vytrannguyenthao/STM32_Hardware_in_the_Loop/Report/Doc/TLTK.tex

\sloppy

\begin{thebibliography}{10}

\bibitem{hil_ni}
National Instruments, "What is Hardware-in-the-Loop (HIL)?",
\url{https://www.ni.com/en/solutions/transportation/hardware-in-the-loop/what-is-hardware-in-the-loop-.html}
(accessed: 12/5/2025).

\bibitem{can}
HQ Kvaser AB, "The CAN Bus Protocol Tutorial",
\url{https://kvaser.com/can-protocol-tutorial/}
(accessed: 12/5/2025).

\bibitem{rtos}
Jonathan Valvano, “Embedded Systems: Real-Time Operating Systems for ARM Cortex-M Microcontrollers”, 2017.

\bibitem{hil_ni}
Keysight Technologies, "What Is the Fourier Transform??", 
\url{https://www.keysight.com/used/us/en/knowledge/formulas/fourier-transform}
(accessed: 12/5/2025).

\bibitem{signal_process}
Sophocles J. Orfanidis, "Introduction to Signal and Processing", Rutgers University, 2010.

\bibitem{dsp}
Steven W. Smith, "The Scientist and Engineer's Guide to Digital Signal Processing", California Technical Publishing San Diego, 1999.

\bibitem{rm_f4}
STMicroelectronics, \textit{STM32F4x Series Reference Manual}, RM0090, 2023.

\bibitem{w25q}
Winbond Electronics Corporation, 
\textit{W25Q Series Serial Flash Memory Datasheet}, 2023.

\bibitem{ds1307}
Maxim Integrated, 
\textit{DS1307 I2C Real-Time Clock Datasheet}, 2016.

\bibitem{at24cxx}
Microchip Technology Inc., 
\textit{AT24Cxx I2C Serial EEPROM Datasheet}, 2018.

\bibitem{rasp_pi}
Raspberry Pi Ltd, 
\textit{RP2040 Datasheet A microcontroller by Raspberry Pi}, 2019.

\end{thebibliography}
