vytrannguyenthao/STM32_Hardware_in_the_Loop/Report/Doc/main.tex

\documentclass[12pt, a4paper]{extreport}
\usepackage[utf8]{vietnam}
\usepackage{mathptmx} % Gói lệnh để sử dụng font Times New Roman
\usepackage{amsmath,amsfonts,amssymb}
\usepackage{graphicx, float}
\usepackage[left=4cm, right=2.5cm, top=4cm, bottom=2.5cm]{geometry}
\usepackage{setspace}
\usepackage{array, booktabs, subcaption}
\usepackage{titlesec}
\usepackage{fancyhdr}
\usepackage{tikz}
\usetikzlibrary{calc,positioning,shapes,arrows}
\usepackage[titles]{tocloft} 
\usepackage{indentfirst}
\usepackage{pdfpages}
\usepackage{listings}
\usepackage{enumitem}
\usepackage{url}
\usepackage{tabularx}
\usepackage{pifont}
\usepackage{longtable}
\usepackage[hidelinks]{hyperref} % Hyperlink nên đặt ở cuối cùng
\usepackage{rotating}

\setlength{\emergencystretch}{3em}
\setcounter{secnumdepth}{3}

% --- Font size & line spacing ---
\renewcommand{\normalsize}{\fontsize{13}{15.6}\selectfont}
\normalsize % Lệnh bắt buộc để kích hoạt size 13pt
\setstretch{1.3} % Giãn dòng 1.3
\setlength{\parskip}{6pt}
\setlist[itemize]{itemsep=1pt, topsep=1pt, parsep=1pt}
\setlist[enumerate]{itemsep=1pt, topsep=1pt, parsep=1pt}

% --- Header & Footer ---
\pagestyle{fancy}
\fancyhf{}
\fancyhead[L]{\textit{Đồ án tốt nghiệp}}
\fancyhead[R]{\textit{GVHD: ThS. Bùi Quốc Bảo}}
\fancyfoot[C]{\thepage}

\fancypagestyle{plain}{
    \fancyhf{}
    \fancyhead[L]{\textit{Đồ án tốt nghiệp}}
    \fancyhead[R]{\textit{GVHD: ThS. Bùi Quốc Bảo}}
    \fancyfoot[C]{\thepage}
}

% \setlength{\headheight}{25pt}
% \setlength{\footskip}{20pt}
\setlength{\parindent}{20pt}

% --- Cấu hình lại khoảng cách cho hình ảnh/bảng ---
\setlength{\intextsep}{0pt} 
\setlength{\belowcaptionskip}{0pt}

% --- Đánh số liên tục Hình ảnh và Bảng biểu ---
\counterwithout{figure}{chapter}
\counterwithout{table}{chapter}

% --- TOC / LOF / LOT spacing ---
\setlength{\cftbeforetoctitleskip}{0pt}  % khoảng cách trước tiêu đề TOC
\setlength{\cftaftertoctitleskip}{10pt}  % khoảng cách sau tiêu đề TOC

\setlength{\cftbeforeloftitleskip}{0pt}  % trước LOF
\setlength{\cftafterloftitleskip}{10pt}  % sau LOF

\setlength{\cftbeforelottitleskip}{0pt}  % trước LOT
\setlength{\cftafterlottitleskip}{10pt}  % sau LOT

% --- Chapter style ---
\titleformat{\chapter}[block]
  {\fontsize{14}{16.8}\selectfont\bfseries\centering} % Cỡ chữ 14, in đậm, canh giữa
  {CHƯƠNG \thechapter}
  {1em} % Khoảng cách giữa số chương và tên chương
  {\MakeUppercase} % Tự động in hoa toàn bộ tên chương

\titlespacing*{\chapter}{0pt}{-30pt}{0pt}

% --- Chapter style (Dành cho LỜI CẢM ƠN, MỤC LỤC, TÓM TẮT...) ---
\titleformat{name=\chapter,numberless}[block]
  {\fontsize{14}{16.8}\selectfont\bfseries\centering}
  {}{0pt}
  {\MakeUppercase}
\titlespacing*{name=\chapter,numberless}{0pt}{-30pt}{0pt}

% --- Section style ---
\titleformat{\section}
  {\fontsize{13}{15.6}\selectfont\bfseries} % Size 13pt, in đậm
  {\thesection}
  {1em}
  {}
\titlespacing*{\section}{0pt}{0pt}{0pt} % Khoảng cách: trái, trên, dưới

% --- Subsection style ---
\titleformat{\subsection}
  {\fontsize{13}{15.6}\selectfont\bfseries\itshape} % Size 13pt, in đậm, in nghiêng
  {\thesubsection}
  {1em}
  {}
\titlespacing*{\subsection}{0pt}{0pt}{0pt}

% --- Subsubsection style---
\titleformat{\subsubsection}
  {\fontsize{13}{15.6}\selectfont\itshape} % Size 13pt, in nghiêng (không đậm)
  {\thesubsubsection}
  {1em}
  {}
\titlespacing*{\subsubsection}{0pt}{0pt}{0pt}

\begin{document}

% --- Trang bìa & lời cảm ơn ---
\pagenumbering{gobble} 
\input{titlepage}

\newpage
\newgeometry{left=3cm, right=2cm, top=1cm, bottom=1cm}
\input{nhiemvu}
\restoregeometry

\cleardoublepage
\pagenumbering{roman}
\input{loicamon}

\cleardoublepage
\input{tomtat}

% --- TOC / LOF / LOT ---
\cleardoublepage
\tableofcontents

\cleardoublepage
\begingroup
\renewcommand*{\addvspace}[1]{} % Vô hiệu hóa lệnh chèn khoảng trắng của LaTeX
\listoffigures
\endgroup

\cleardoublepage
\begingroup
\renewcommand*{\addvspace}[1]{} % Vô hiệu hóa lệnh chèn khoảng trắng của LaTeX
\listoftables
\endgroup

% --- Nội dung chương ---
\cleardoublepage
\pagenumbering{arabic}
\input{chuong1}

\newpage
\input{chuong2}

\newpage
\input{chuong3}

\newpage
\input{chuong4}

\newpage
\input{chuong5}

% \newpage
% \input{chuong6}

\newpage
\input{chuong7}

\newpage
\input{chuong8}

\newpage
\input{chuong9}

\newpage
\input{ketluan_huongphattrien}

\newpage
\input{TLTK}

\end{document}
