vytrannguyenthao/STM32_Hardware_in_the_Loop/HIL_project_HW/HIL_project.png

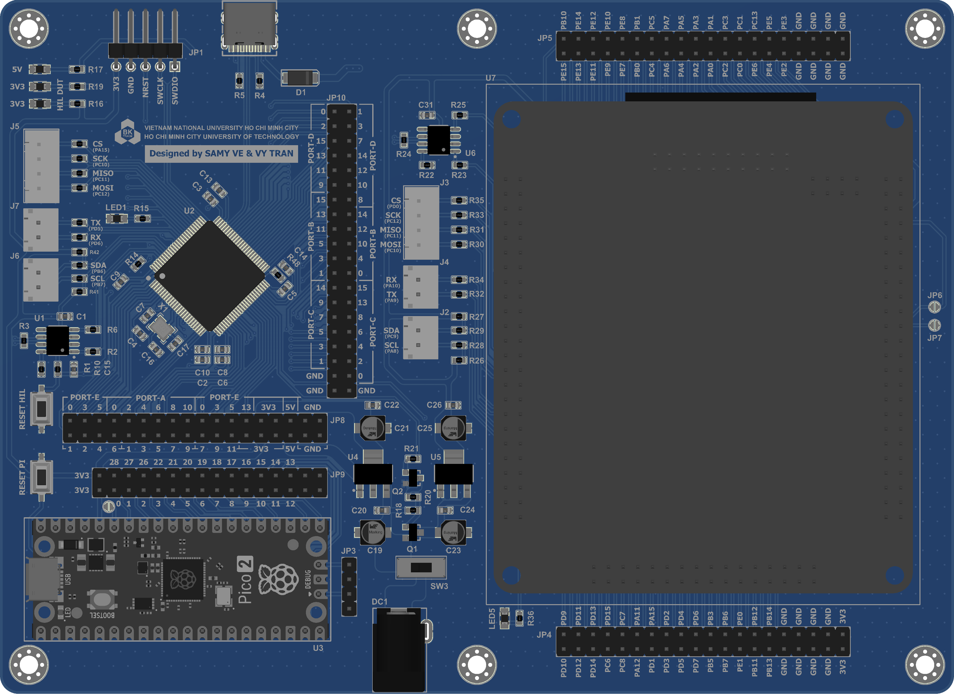
HIL_project_HW/HIL_project.png
