vytrannguyenthao/STM32_Hardware_in_the_Loop/Report/Doc/image/app_mem_emu.jpg

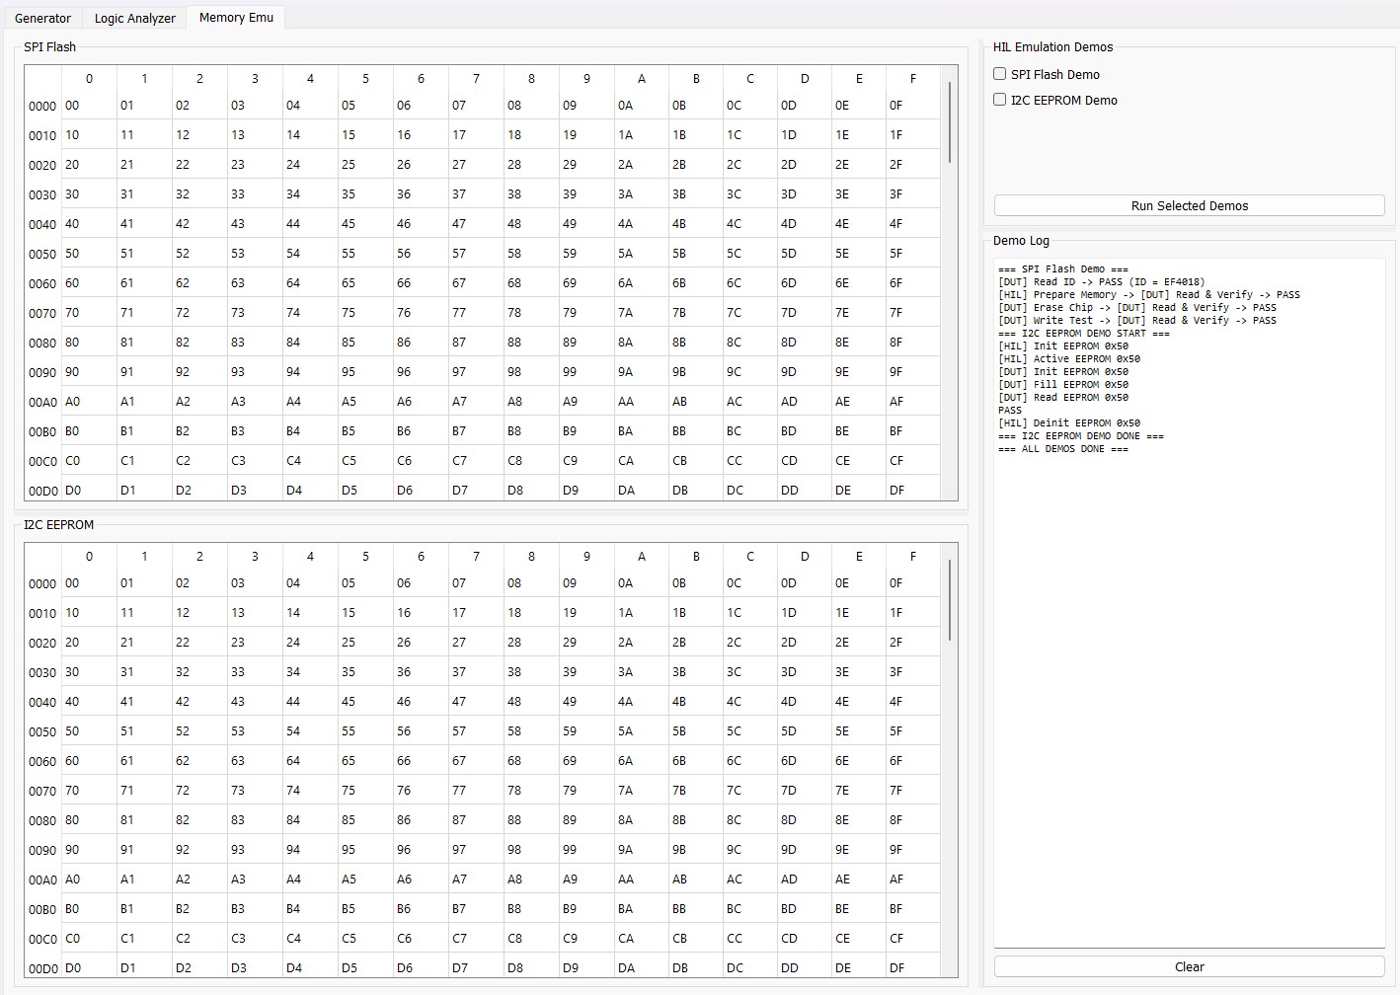
Report/Doc/image/app_mem_emu.jpg
