vytrannguyenthao/STM32_Hardware_in_the_Loop/Report/Doc/image/App_per_adc.jpg

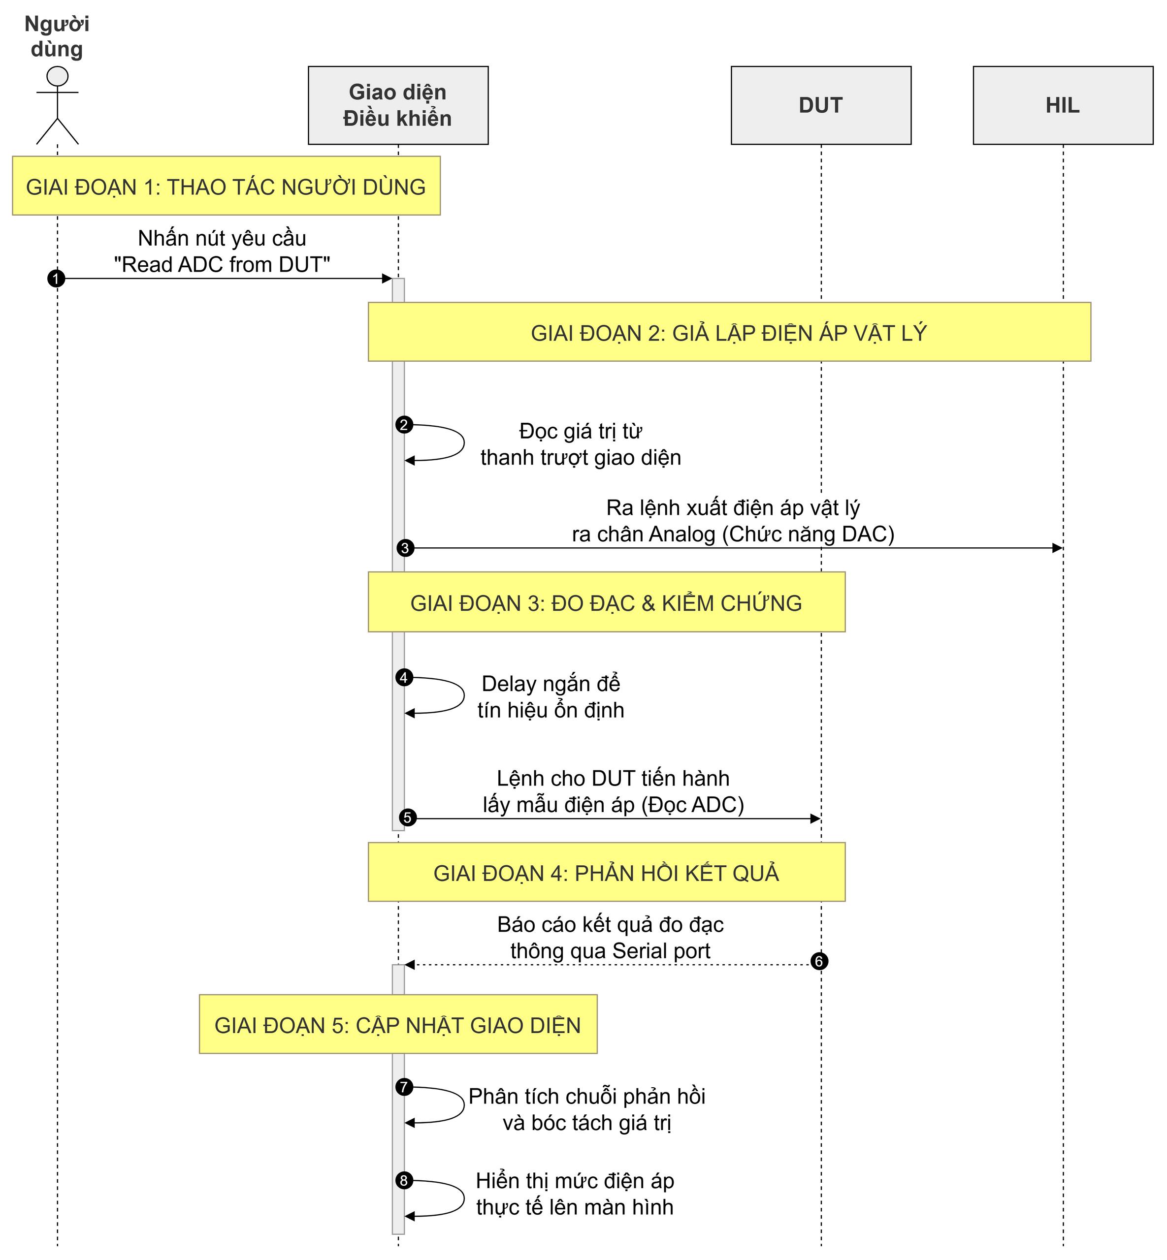
Report/Doc/image/App_per_adc.jpg
