vytrannguyenthao/STM32_Hardware_in_the_Loop/Report/Doc/image/App_per_led.jpg

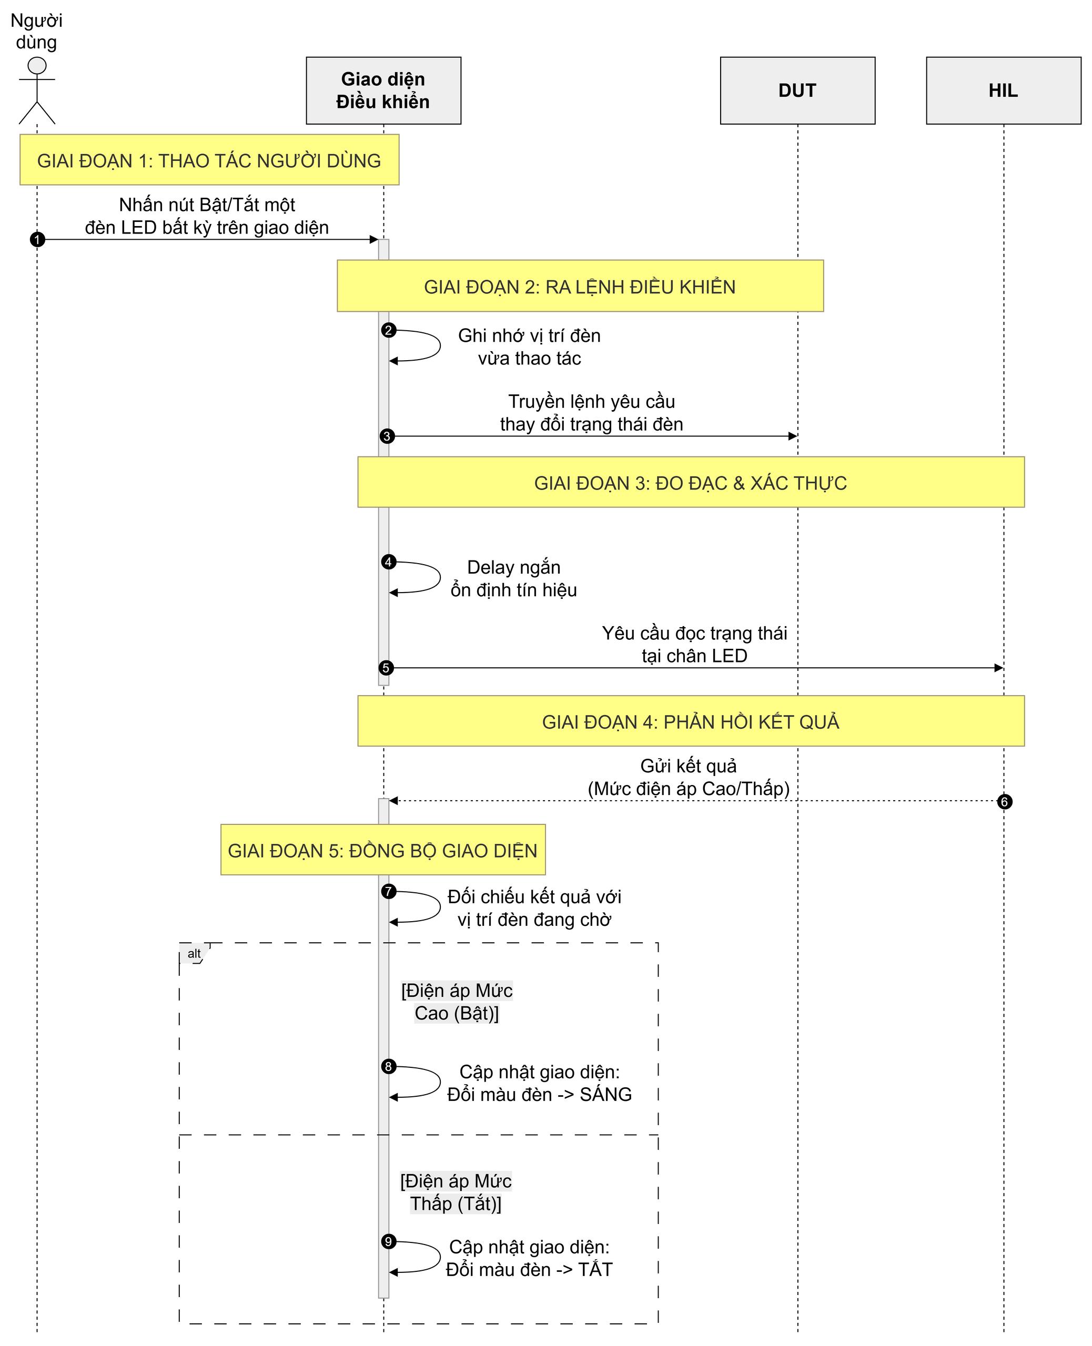
Report/Doc/image/App_per_led.jpg
