vytrannguyenthao/STM32_Hardware_in_the_Loop/Report/Doc/image/cooperative.jpg

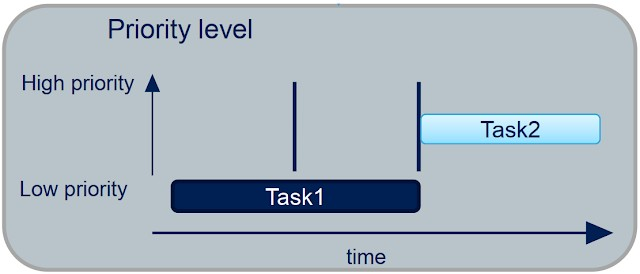
Report/Doc/image/cooperative.jpg
