vytrannguyenthao/STM32_Hardware_in_the_Loop/Report/Doc/image/dequeue.jpg

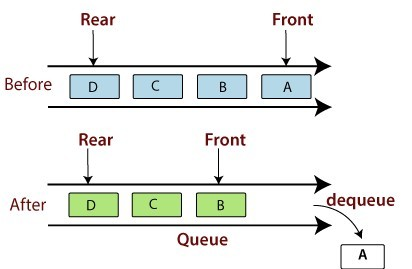
Report/Doc/image/dequeue.jpg
