vytrannguyenthao/STM32_Hardware_in_the_Loop/Report/Doc/image/DUT_CLI_task.png

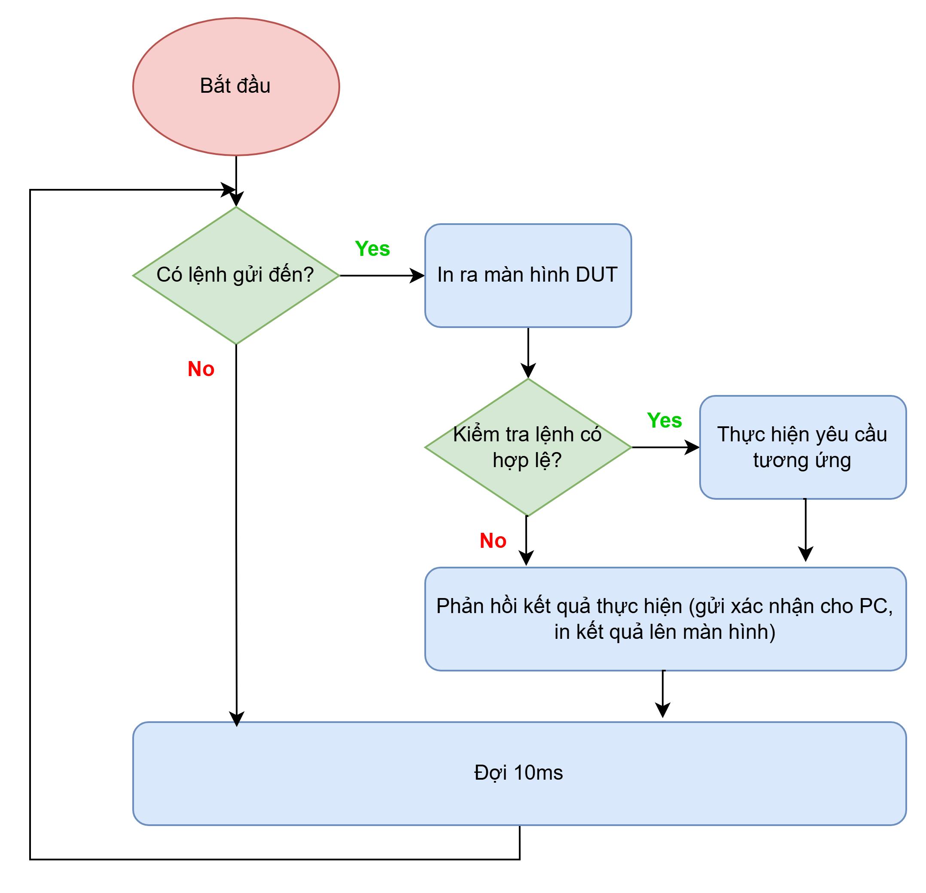
Report/Doc/image/DUT_CLI_task.png
