vytrannguyenthao/STM32_Hardware_in_the_Loop/Report/Doc/image/enqueue.jpg

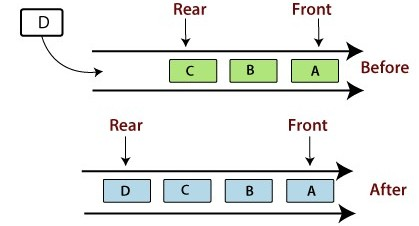
Report/Doc/image/enqueue.jpg
