vytrannguyenthao/STM32_Hardware_in_the_Loop/Report/Doc/image/hard_real_time.jpg

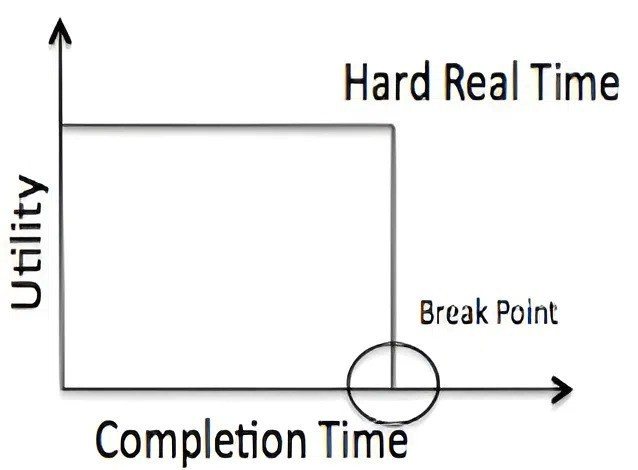
Report/Doc/image/hard_real_time.jpg
