vytrannguyenthao/STM32_Hardware_in_the_Loop/Report/Doc/image/PC_overview.png

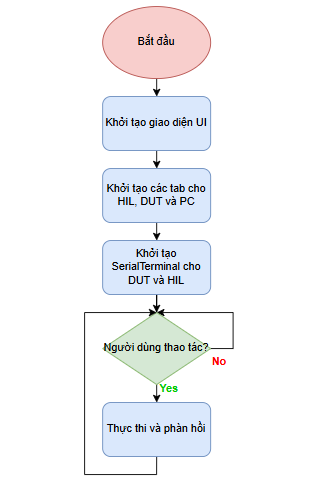
Report/Doc/image/PC_overview.png
