vytrannguyenthao/STM32_Hardware_in_the_Loop/Report/Doc/image/preemptive.jpg

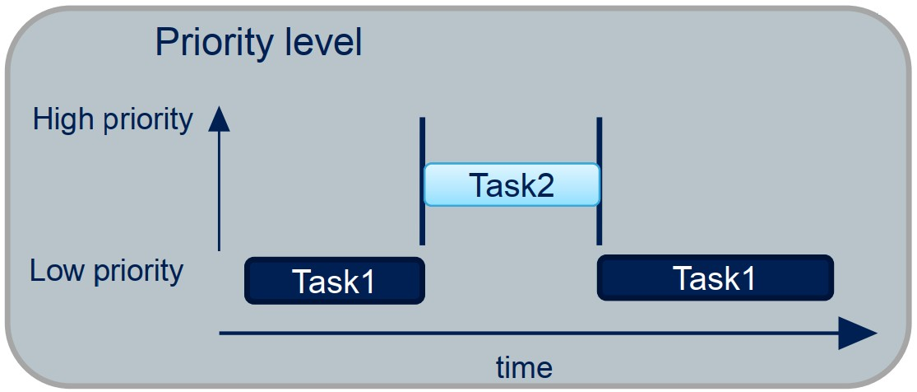
Report/Doc/image/preemptive.jpg
