vytrannguyenthao/STM32_Hardware_in_the_Loop/Report/Doc/image/round_robin.jpg

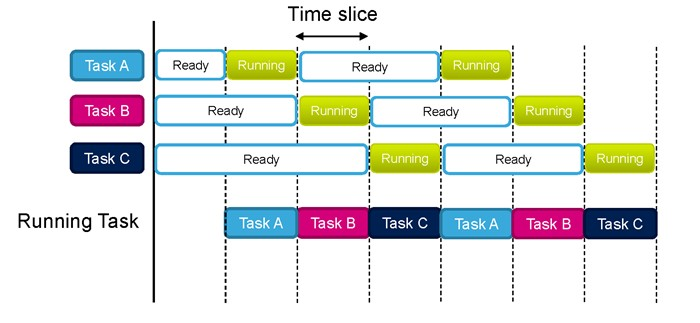
Report/Doc/image/round_robin.jpg
