vytrannguyenthao/STM32_Hardware_in_the_Loop/Report/Doc/image/soft_real_time.jpg

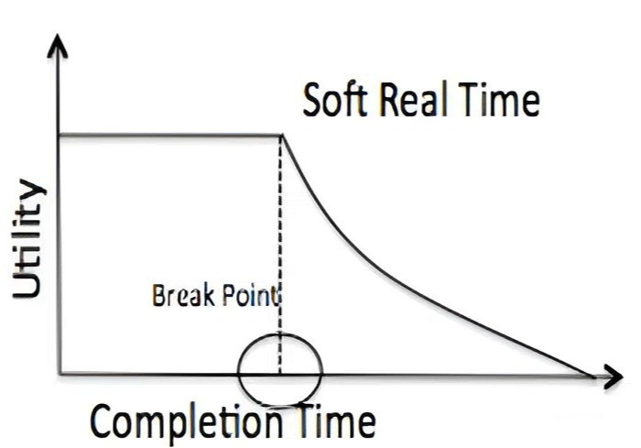
Report/Doc/image/soft_real_time.jpg
