vytrannguyenthao/STM32_Hardware_in_the_Loop/Report/Doc/image/spi_hil_prepare_mem.jpg

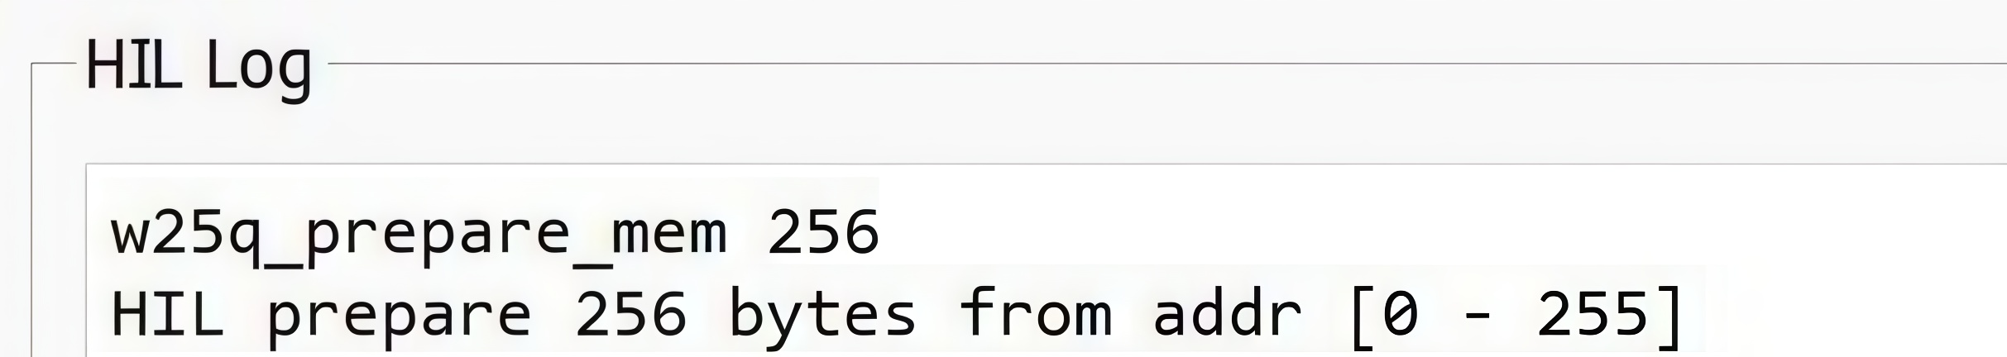
Report/Doc/image/spi_hil_prepare_mem.jpg
