vytrannguyenthao/STM32_Hardware_in_the_Loop/Report/Doc/image/spi_read_after_write.jpg

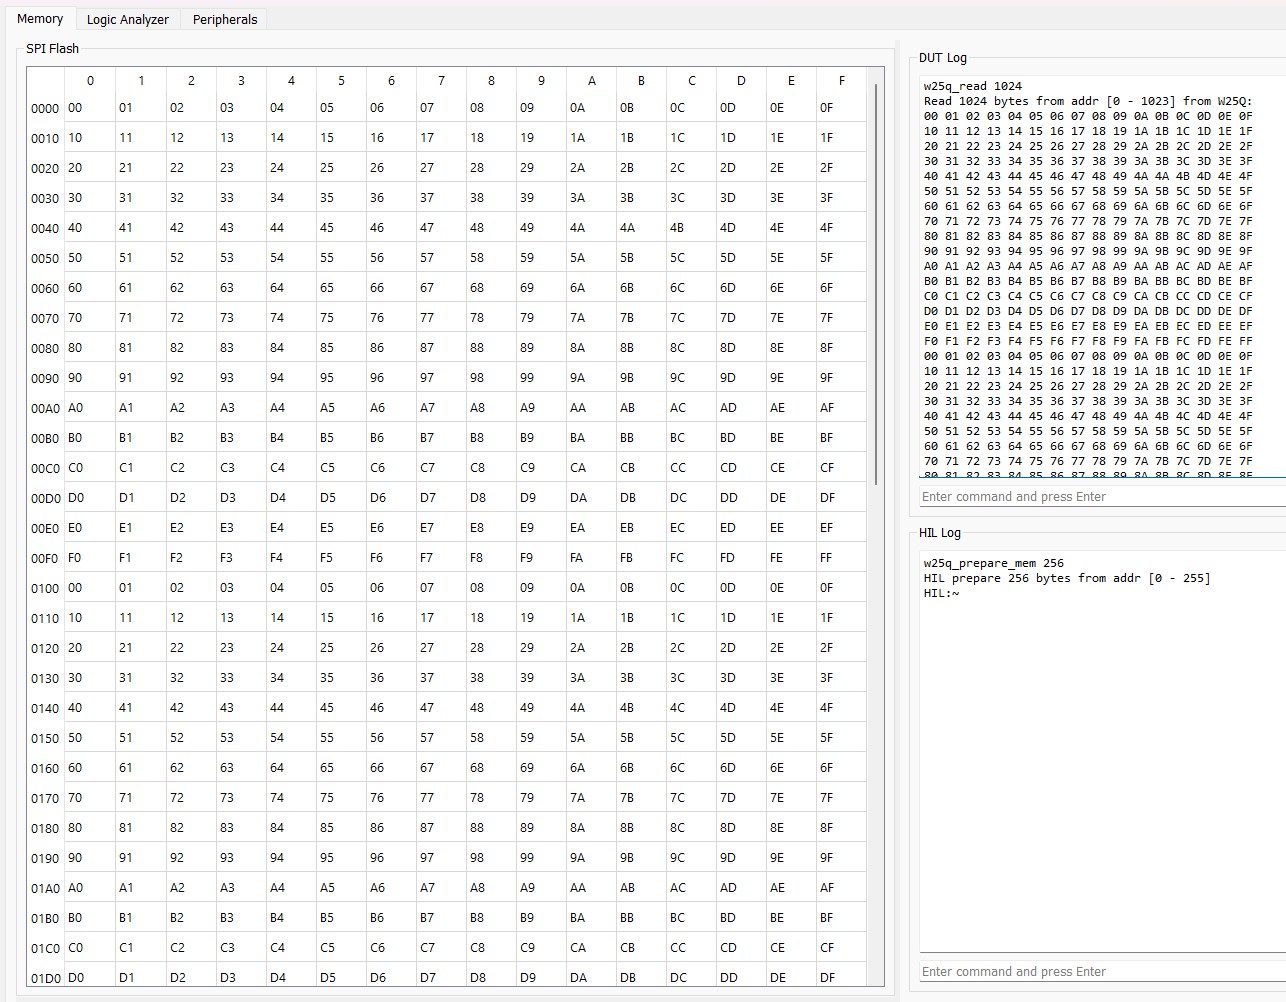
Report/Doc/image/spi_read_after_write.jpg
