vytrannguyenthao/STM32_Hardware_in_the_Loop/Report/Doc/image/spi_read_id.jpg

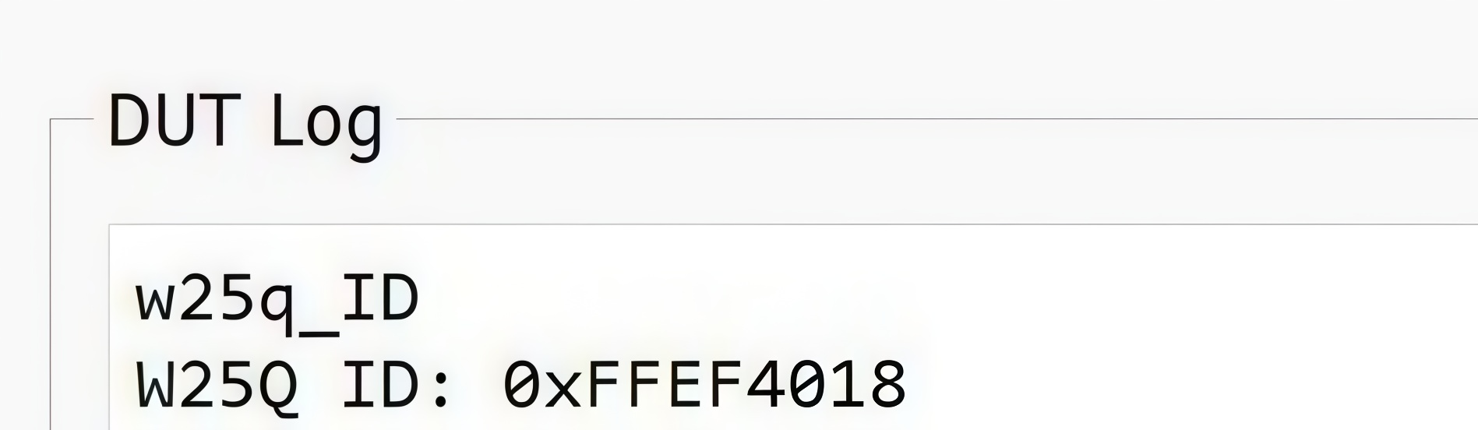
Report/Doc/image/spi_read_id.jpg
