vytrannguyenthao/STM32_Hardware_in_the_Loop/Report/Doc/image/superloop.jpg

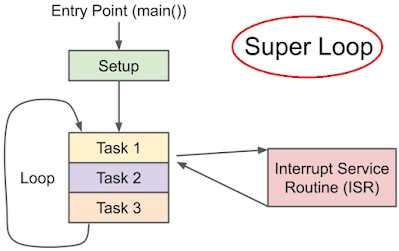
Report/Doc/image/superloop.jpg
