vytrannguyenthao/STM32_Hardware_in_the_Loop/Report/Doc/image/SW_overview.png

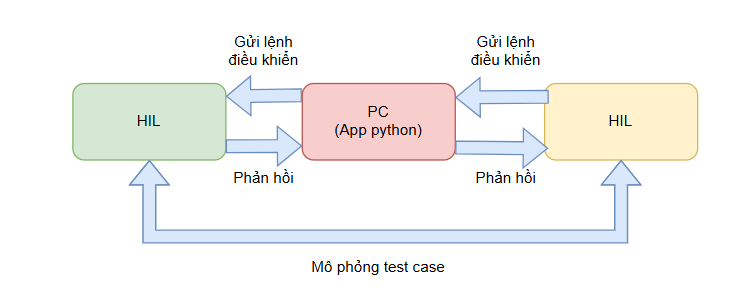
Report/Doc/image/SW_overview.png
