vytrannguyenthao/STM32_Hardware_in_the_Loop/Report/Doc/image/thread_state.jpg

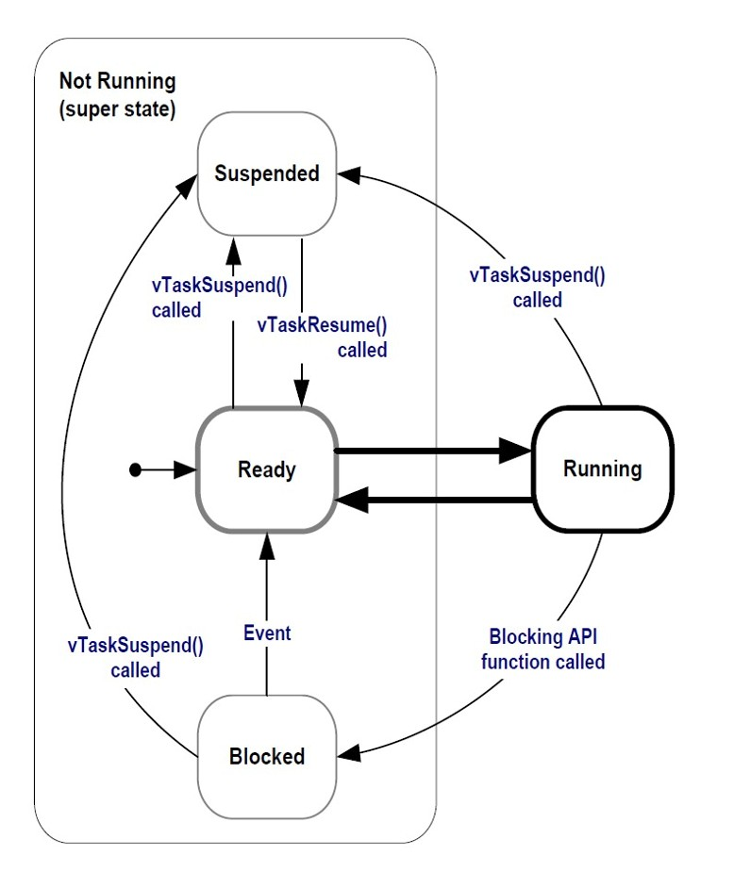
Report/Doc/image/thread_state.jpg
