vytrannguyenthao/STM32_Hardware_in_the_Loop/Report/Doc/image/uart.png

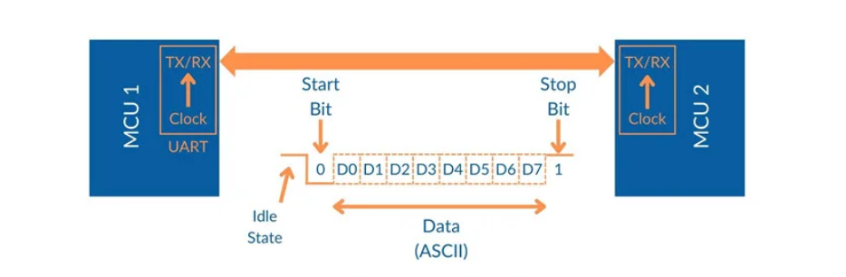
Report/Doc/image/uart.png
