vytrannguyenthao/STM32_Hardware_in_the_Loop/Report/Doc/image/hil_log_result.png

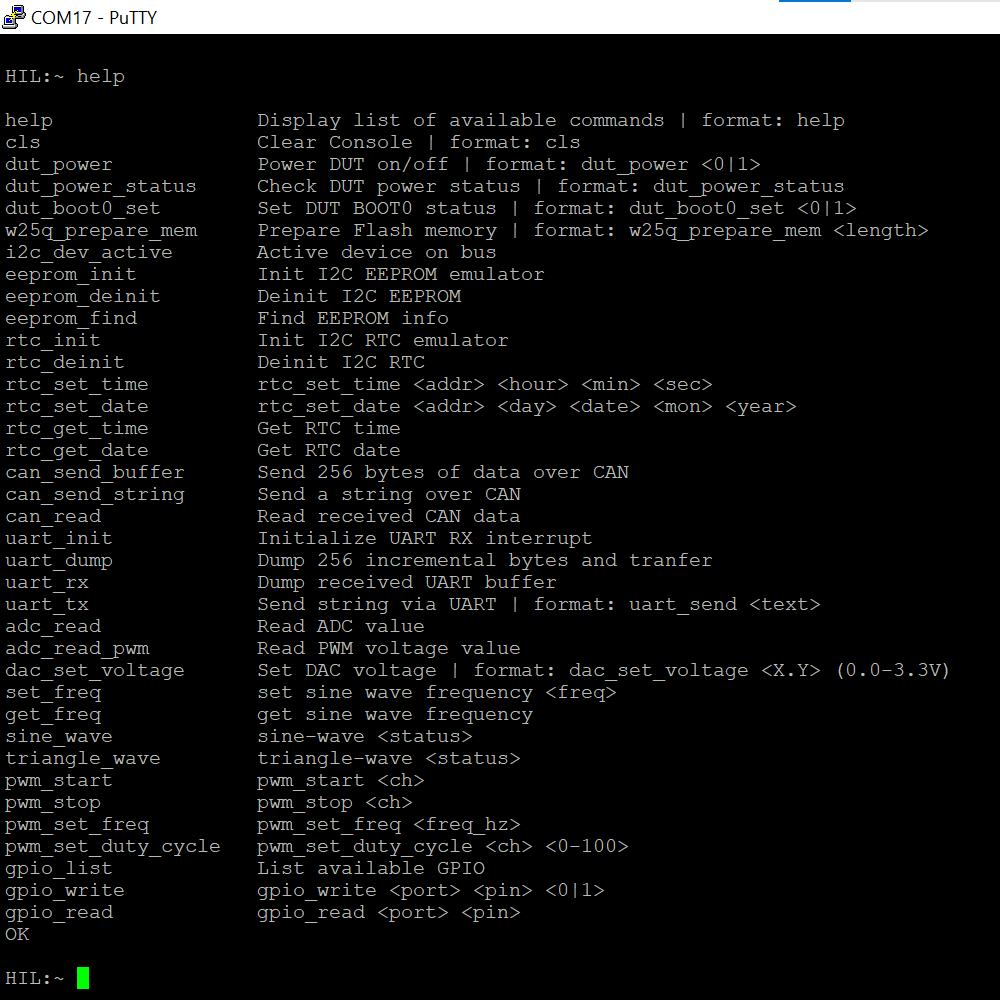
Report/Doc/image/hil_log_result.png
