vytrannguyenthao/STM32_Hardware_in_the_Loop/Report/Doc/image/spi_result.jpg

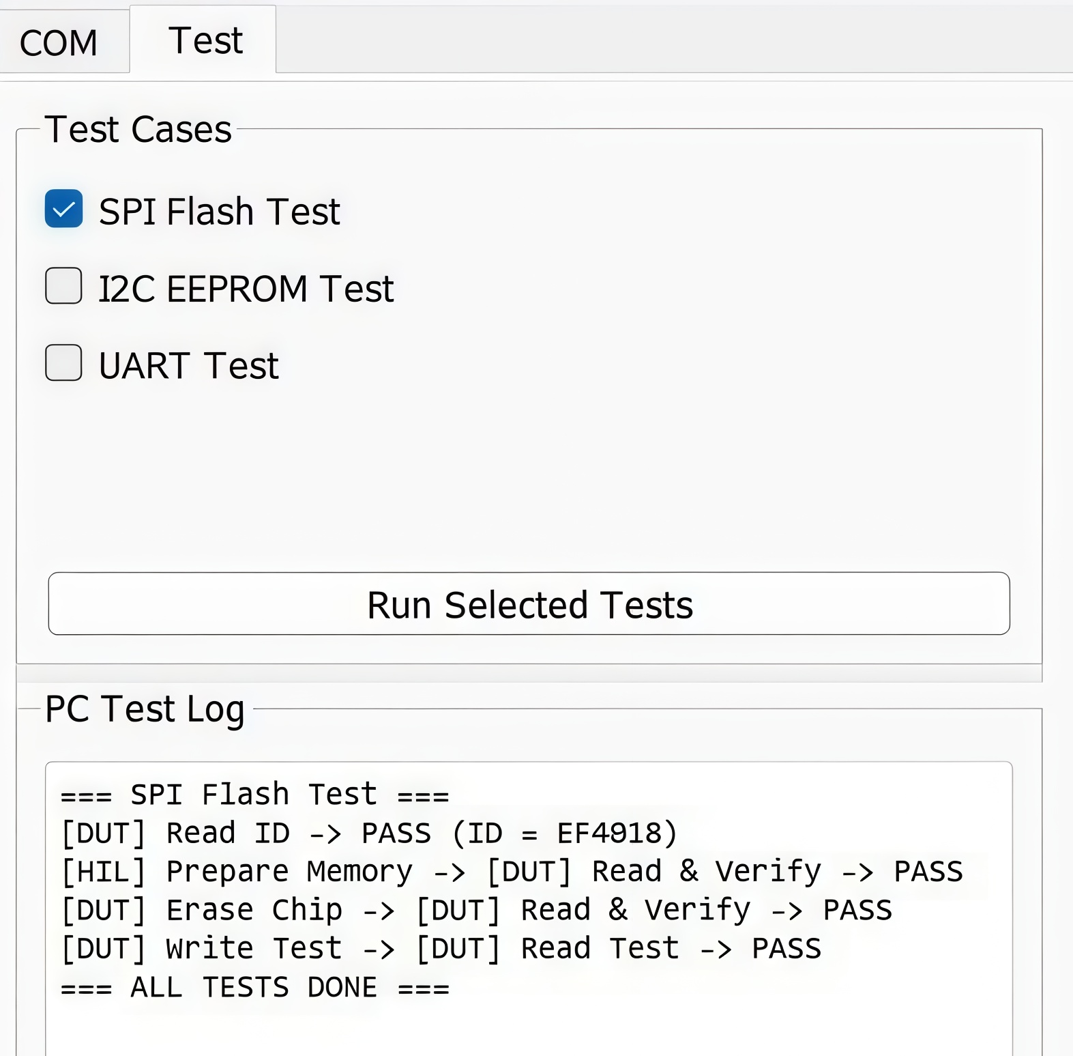
Report/Doc/image/spi_result.jpg
