vytrannguyenthao/STM32_Hardware_in_the_Loop/HIL_project_HW/HIL_Project.pdf

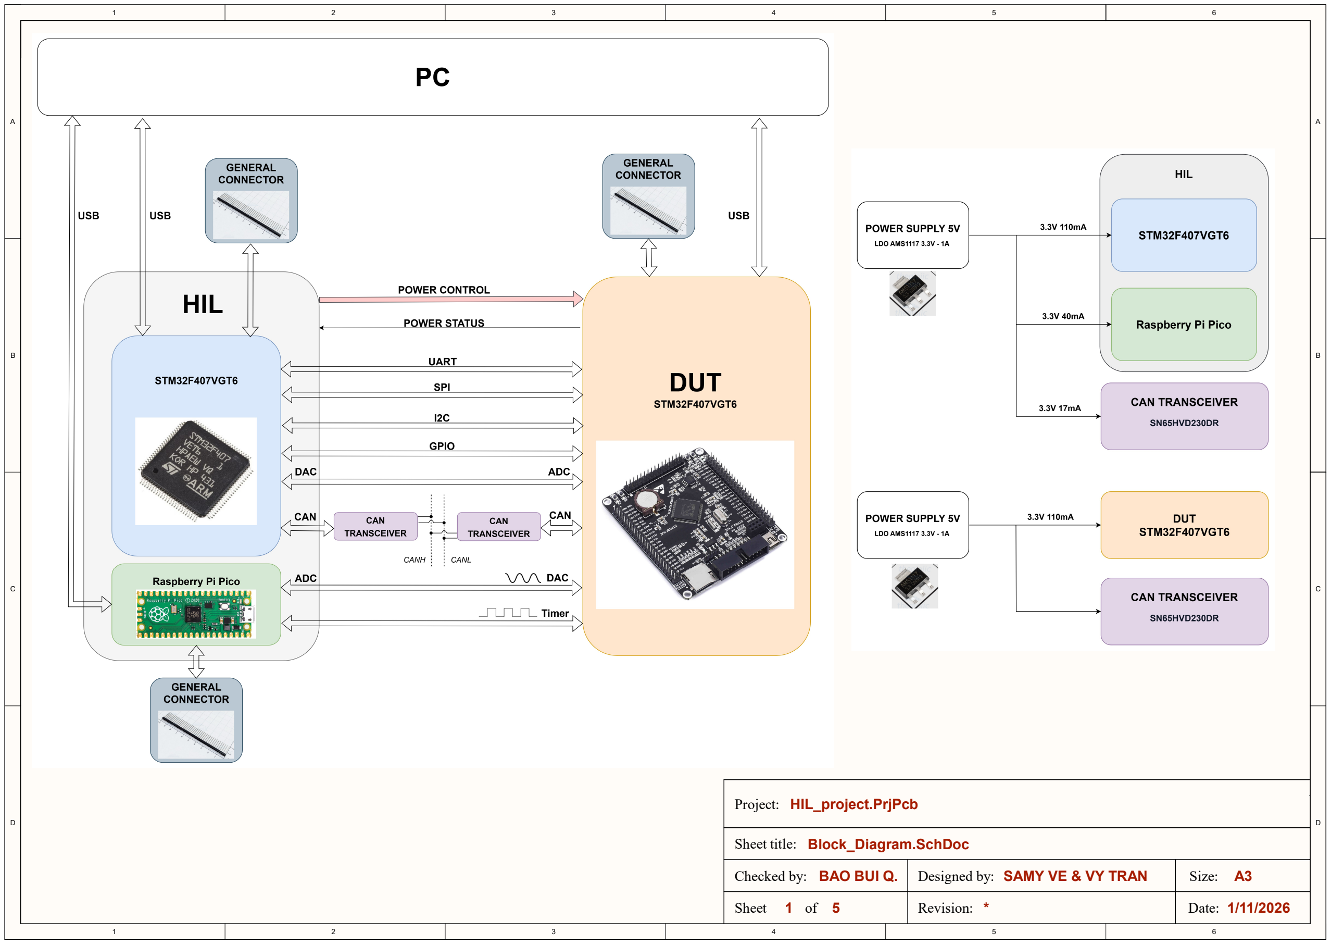
[picture p145: page 1]

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
# Sheet title:

# Project:

Checked by: BAO BUI Q. | Designed by: SAMY VE & VY TRAN | Size: A3
Sheet 1 of 5 | Revision: * | Date: 1/11/2026

# HIL_project.PrjPcb

# Block_Diagram.SchDoc

# HIL DEBUGGER

# HIL USB

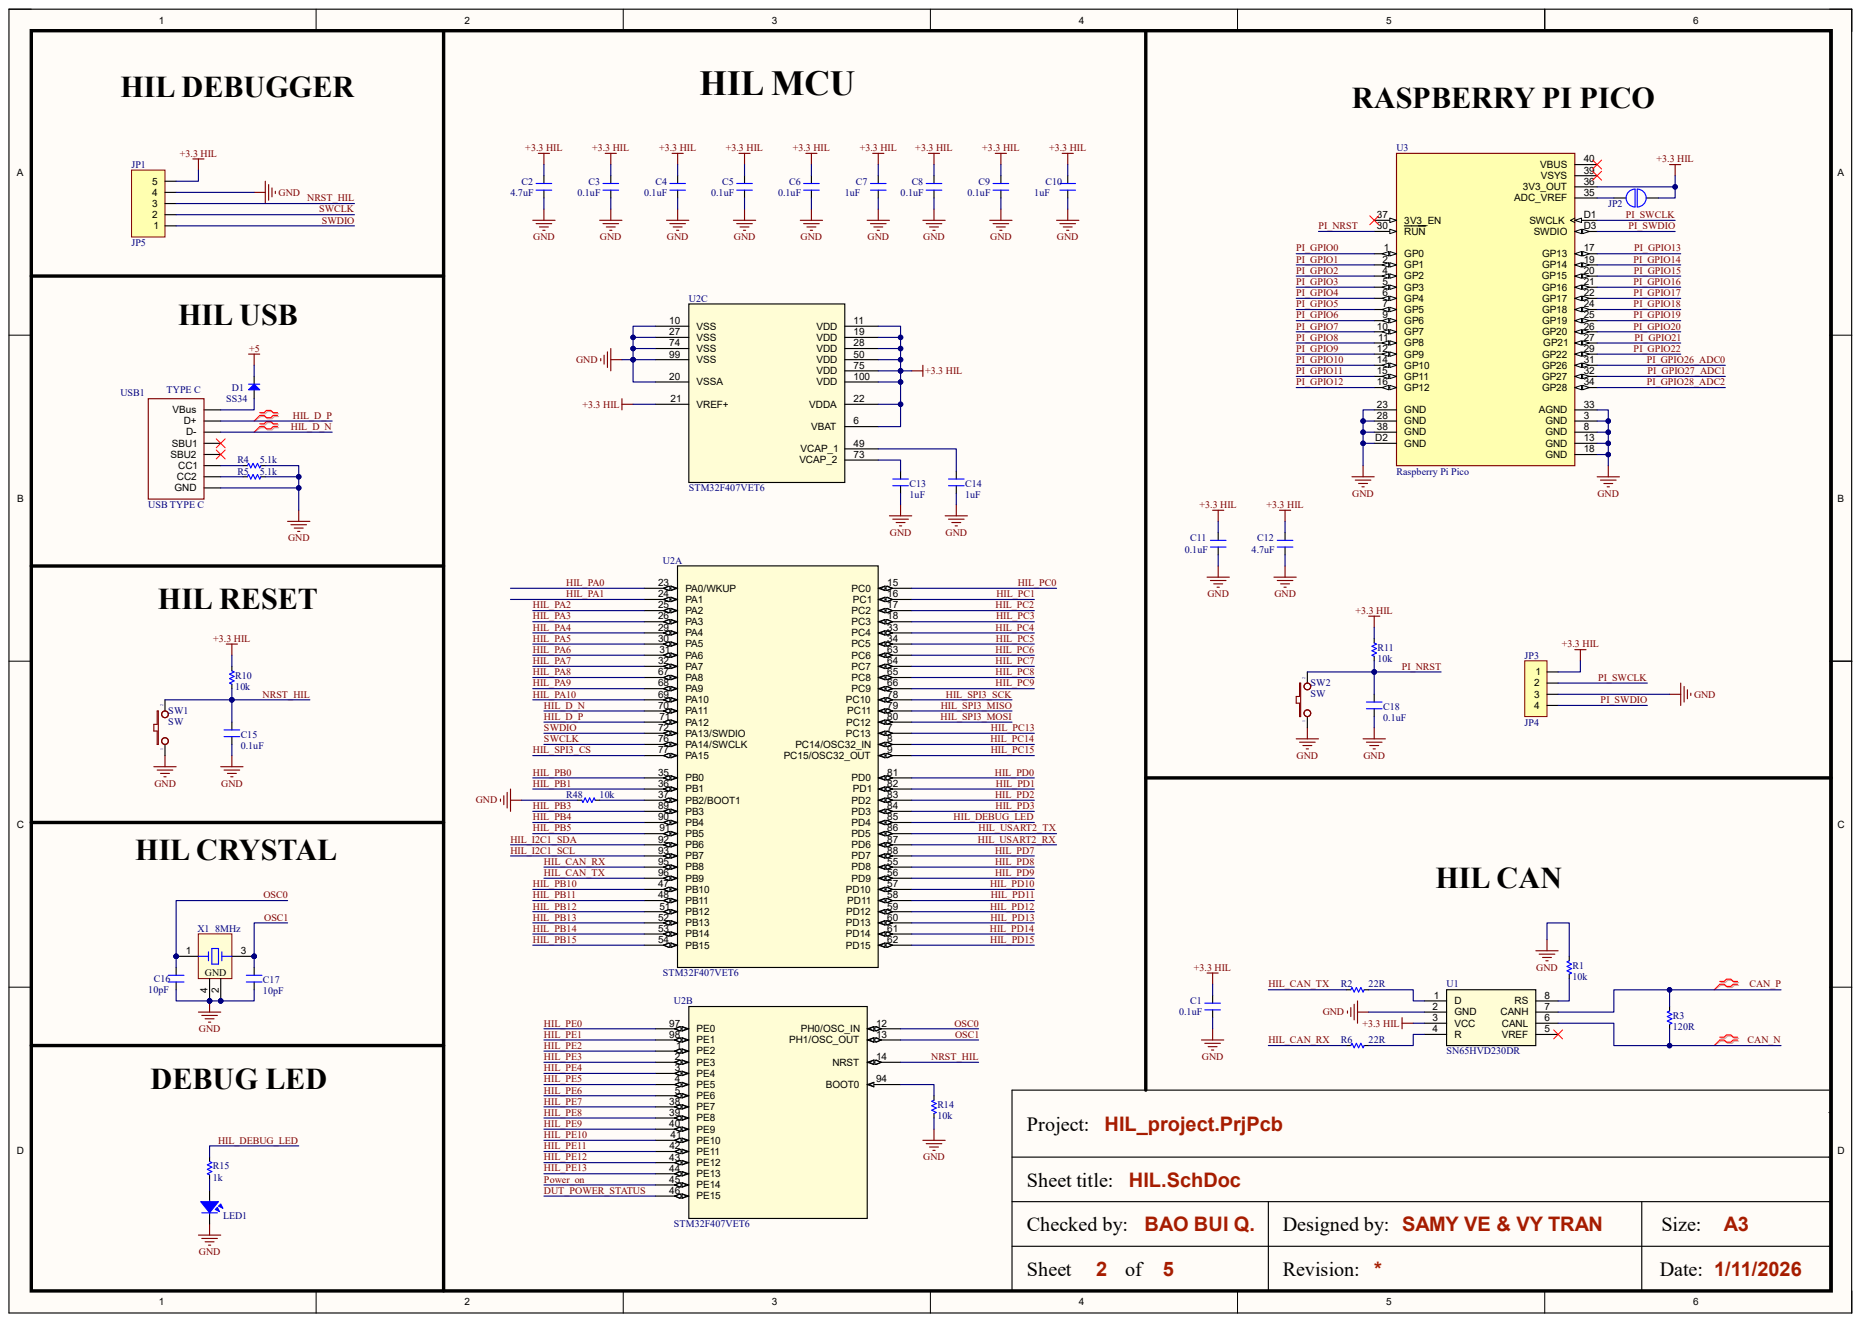
[picture p146: page 2]

# 1/11/2026 GND

# HIL POWER

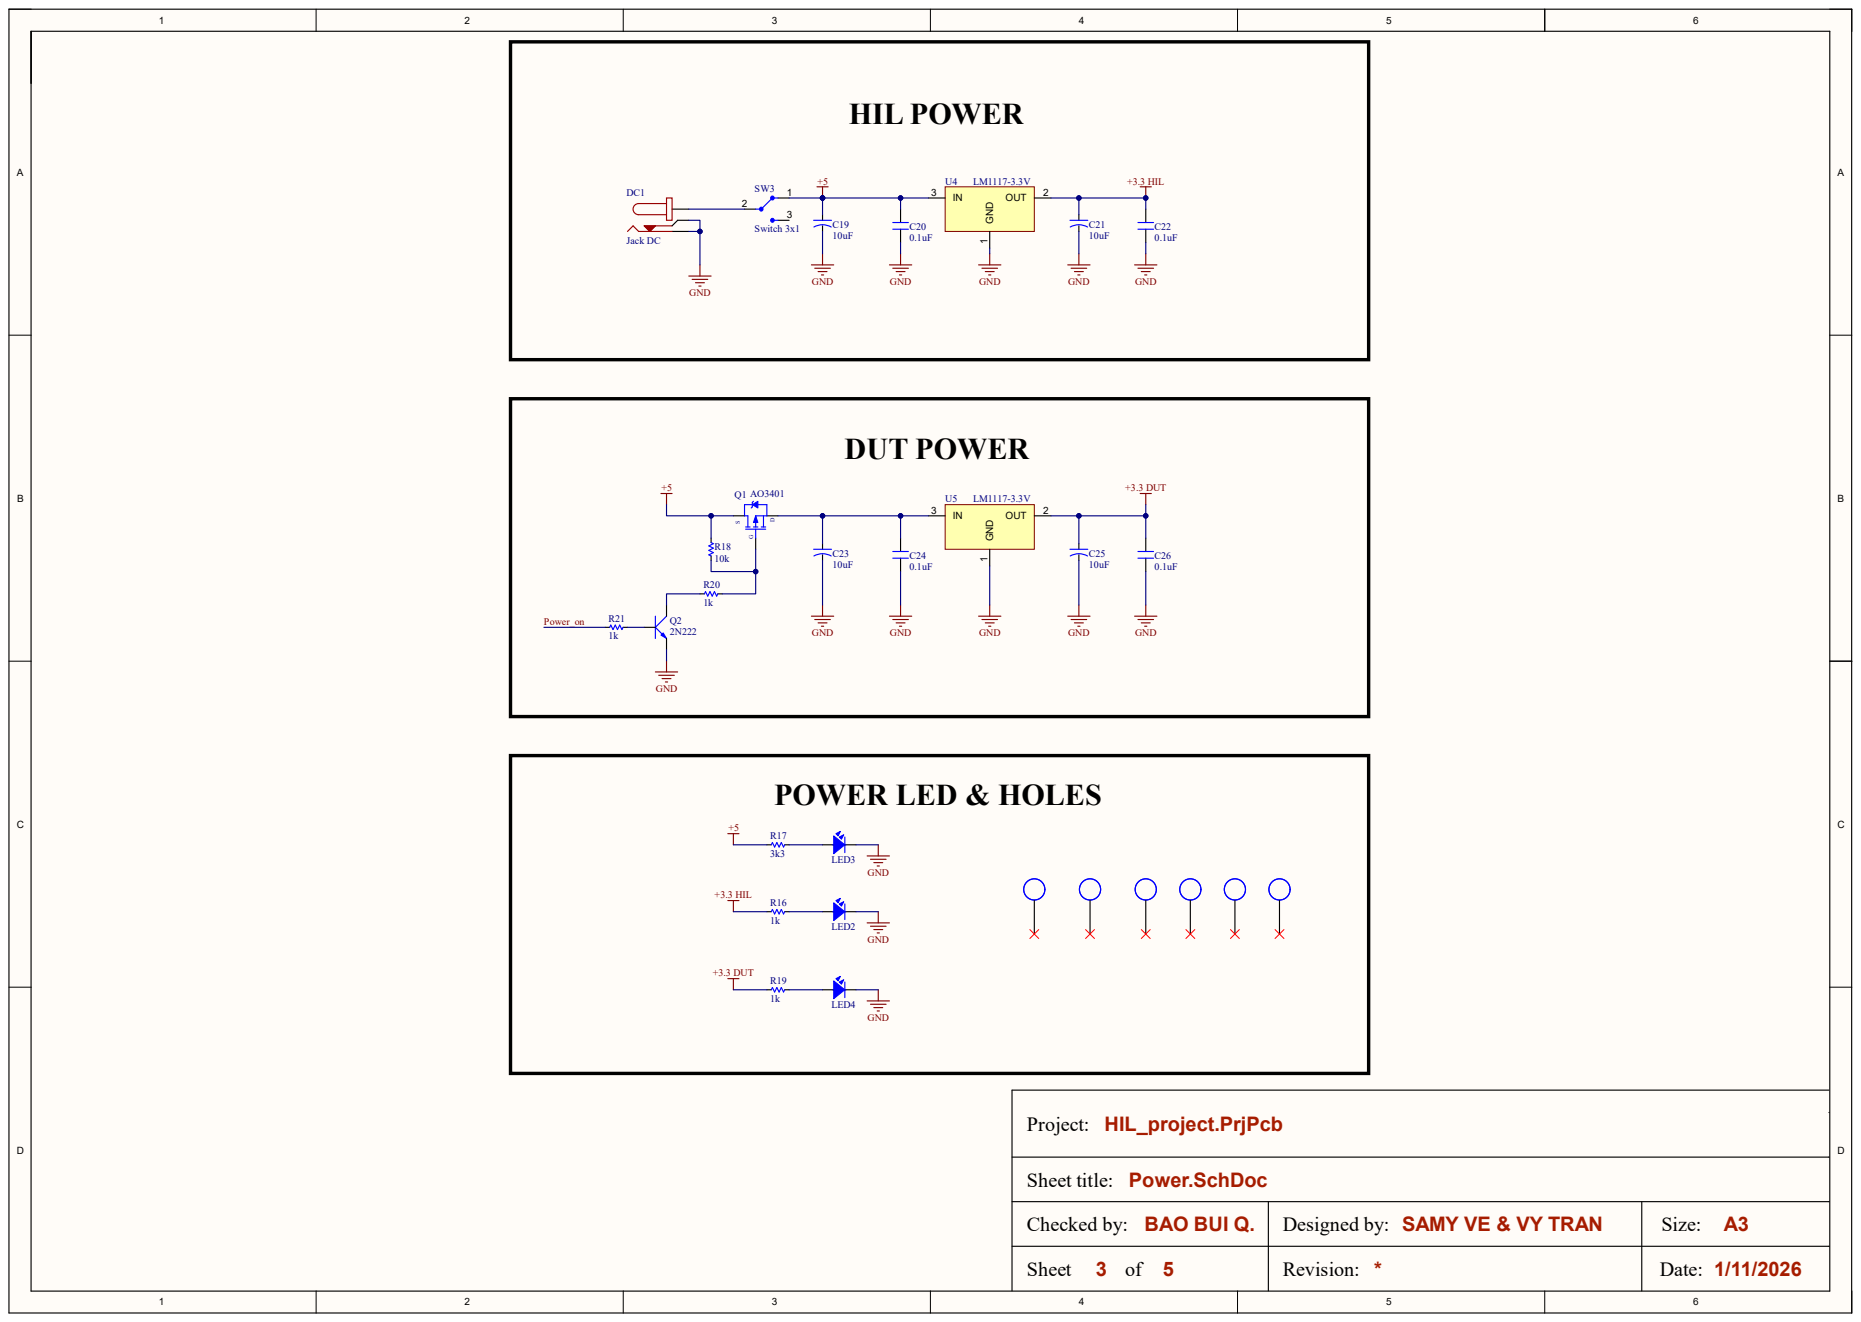
[picture p147: page 3]

# DUT CAN

# DUT STM32F407 DEV KIT

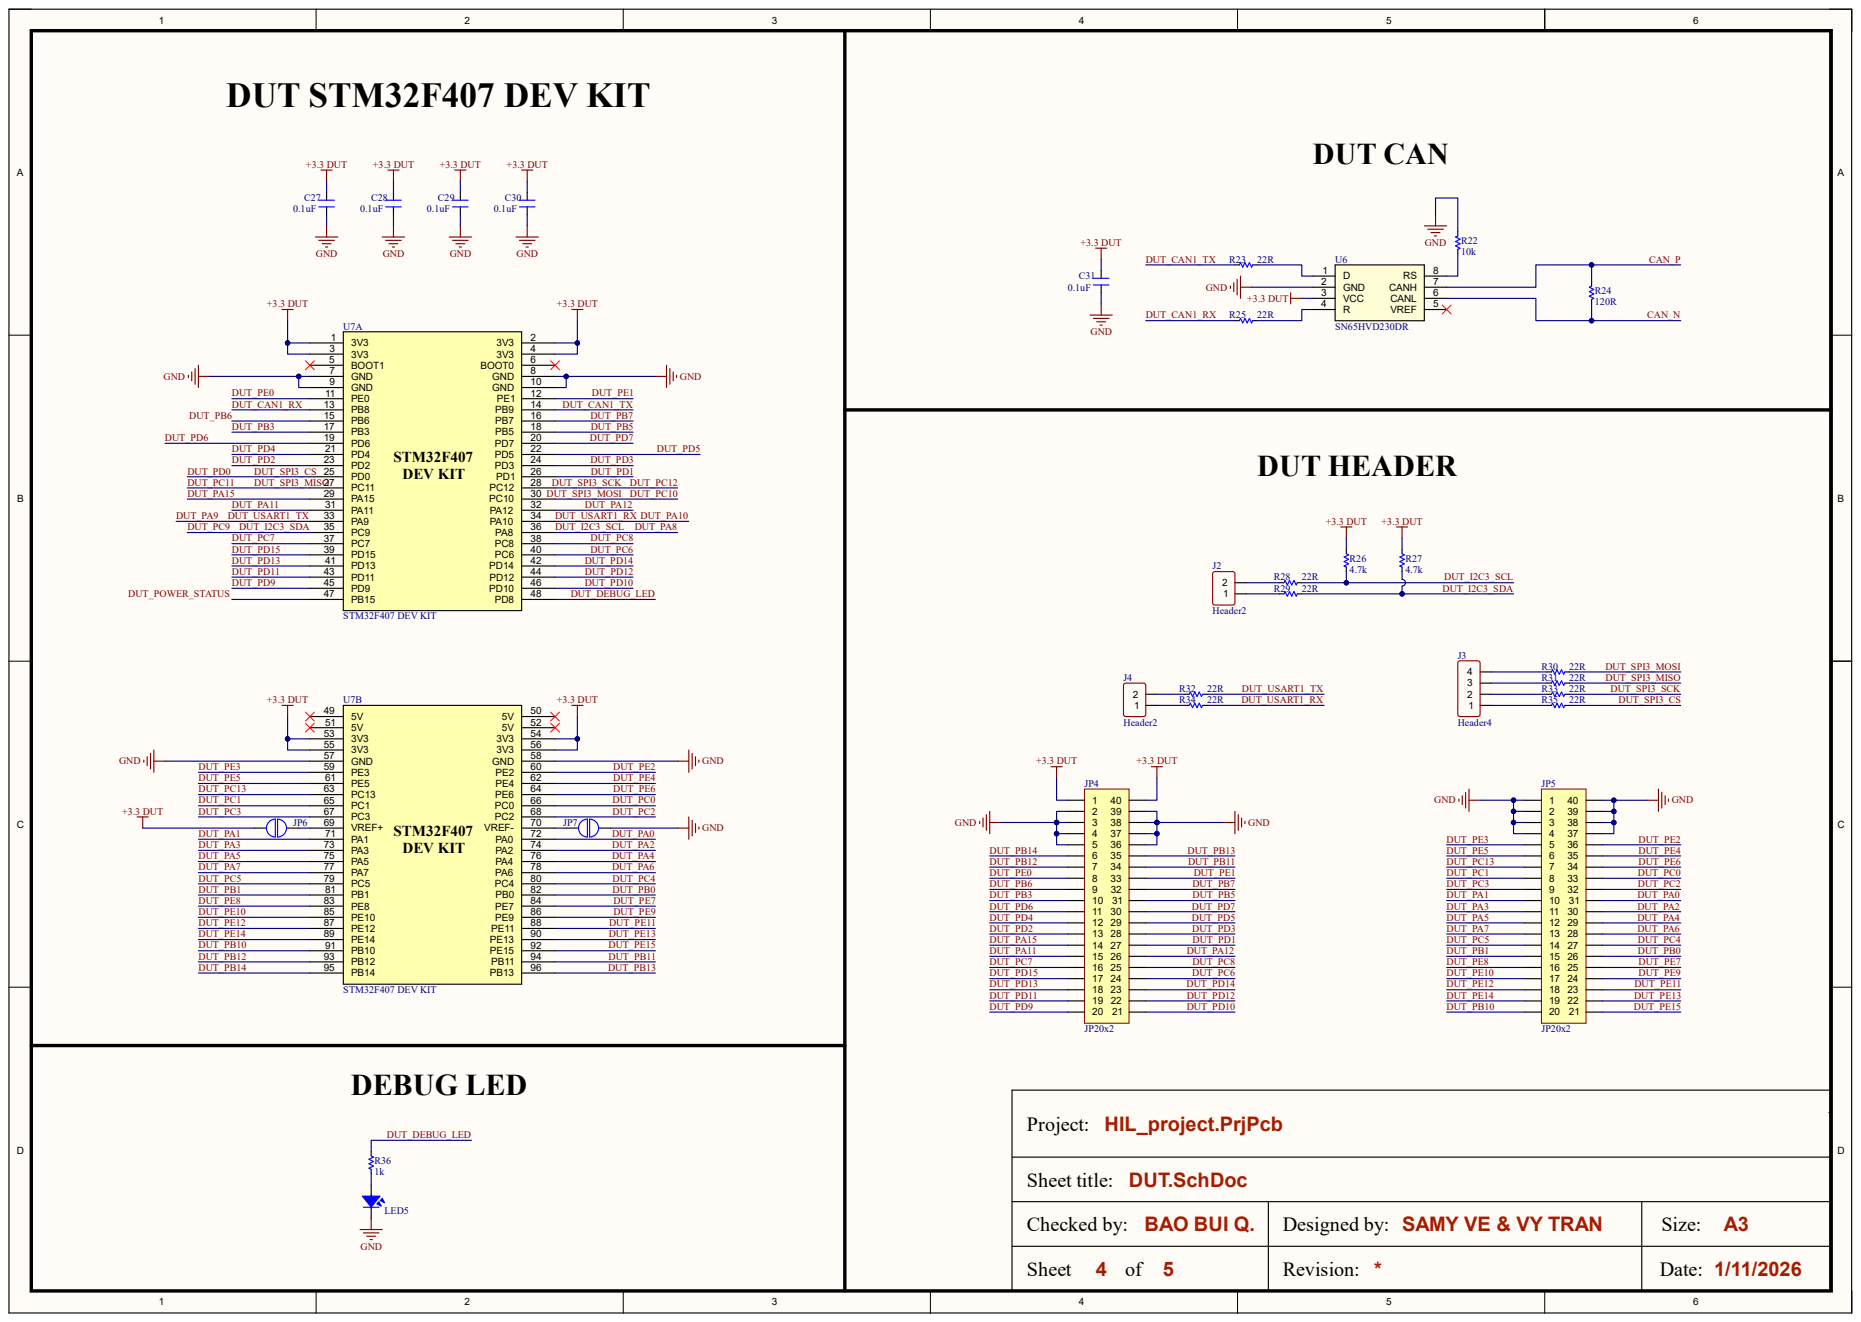
[picture p148: page 4]

# HIL HEADER

# PI PICO HEADER

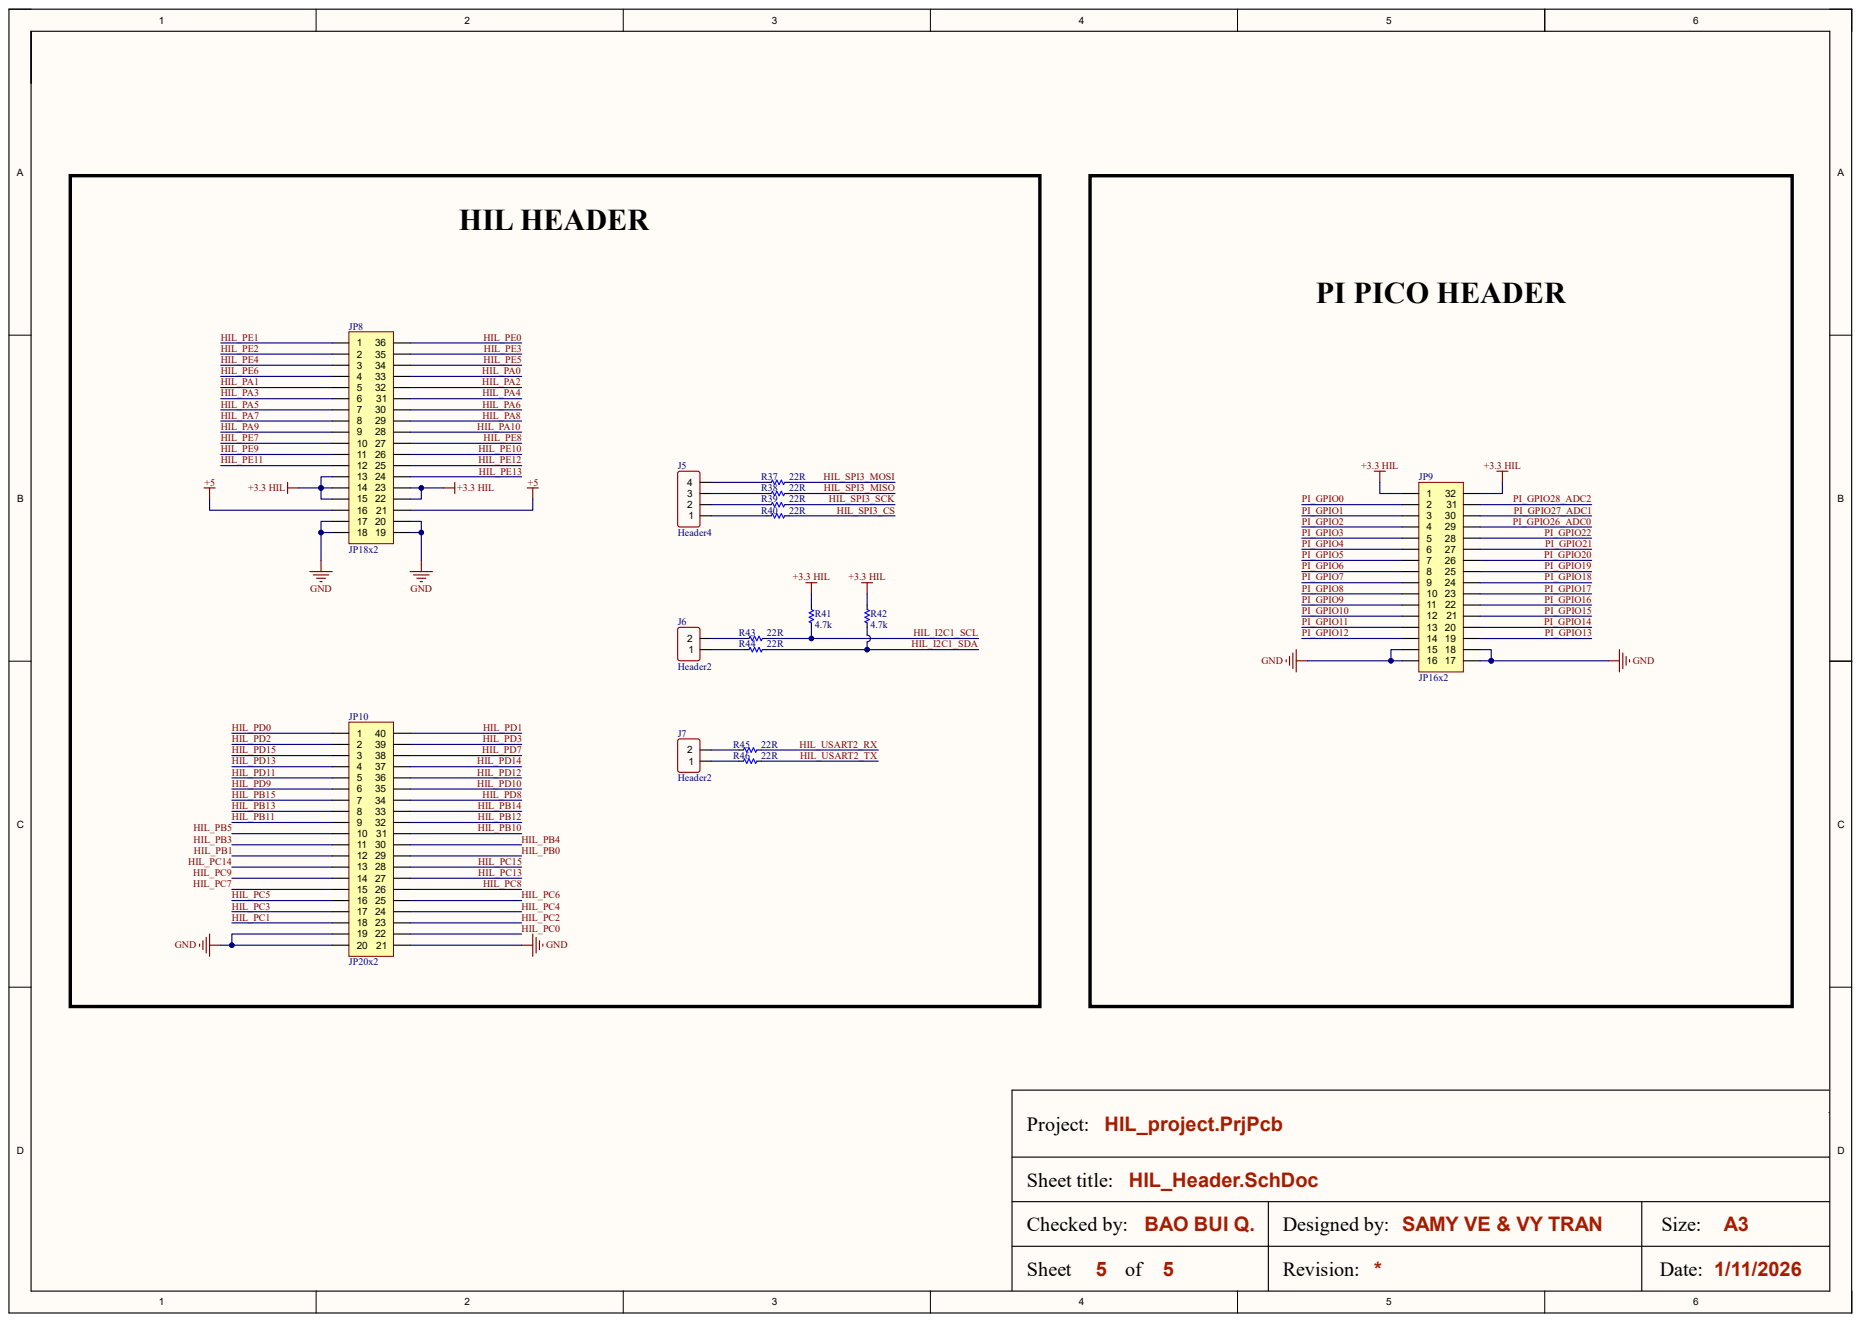
[picture p149: page 5]
