vytrannguyenthao/STM32_Hardware_in_the_Loop/(list of files, drawings)

Other design files:
HIL_project_HW/Block_Diagram.SchDoc
HIL_project_HW/DUT.SchDoc
HIL_project_HW/HIL.SchDoc
HIL_project_HW/HIL_Header.SchDoc
HIL_project_HW/HIL_project.PrjPcb
HIL_project_HW/HIL_project.SCHLIB
HIL_project_HW/Power.SchDoc
