vytrannguyenthao/STM32_Hardware_in_the_Loop/STM32F4_HIL/Core/Src/main.c

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
/* Includes ------------------------------------------------------------------*/
#include "main.h"
#include "usb_device.h"

/* USER CODE BEGIN Includes */
#include <string.h>
#include <stdarg.h>
#include <stdio.h>
#include <stm32f4xx_ll_gpio.h>
#include "FreeRTOS.h"
#include "task.h"
#include "usbd_cdc_if.h"
#include "cmd.h"
#include "w25q_slave.h"
#include "i2c_rtc.h"
#include "can_driver.h"
#include "analog.h"
/* USER CODE END Includes */

ADC_HandleTypeDef hadc1;

CAN_HandleTypeDef hcan1;

DAC_HandleTypeDef hdac;
DMA_HandleTypeDef hdma_dac1;

I2C_HandleTypeDef hi2c1;

TIM_HandleTypeDef htim2;
TIM_HandleTypeDef htim3;
TIM_HandleTypeDef htim4;
TIM_HandleTypeDef htim5;

UART_HandleTypeDef huart2;

void SystemClock_Config(void);
static void MX_GPIO_Init(void);
static void MX_DMA_Init(void);
static void MX_I2C1_Init(void);
static void MX_TIM2_Init(void);
static void MX_TIM3_Init(void);
static void MX_SPI3_Init(void);
static void MX_CAN1_Init(void);
static void MX_DAC_Init(void);
static void MX_ADC1_Init(void);
static void MX_USART2_UART_Init(void);
static void MX_TIM4_Init(void);
static void MX_TIM5_Init(void);
/* USER CODE BEGIN PFP */
void CDC_printf(const char *fmt, ...);
static void toggle_led(void *pvParameters);
/* USER CODE END PFP */

/* USER CODE BEGIN 0 */
uint32_t cnt = 0;
/* USER CODE END 0 */

/**
  * @brief  The application entry point.
  * @retval int
  */
int main(void)
{

  /* MCU Configuration--------------------------------------------------------*/

  /* Reset of all peripherals, Initializes the Flash interface and the Systick. */
  HAL_Init();

  /* Configure the system clock */
  SystemClock_Config();

  /* Initialize all configured peripherals */
  MX_GPIO_Init();
  MX_DMA_Init();
  MX_I2C1_Init();
  MX_USB_DEVICE_Init();
  MX_TIM2_Init();
  MX_TIM3_Init();
  MX_SPI3_Init();
  MX_CAN1_Init();
  MX_DAC_Init();
  MX_ADC1_Init();
  MX_USART2_UART_Init();
  MX_TIM4_Init();
  MX_TIM5_Init();
  /* USER CODE BEGIN 2 */
  HAL_TIM_Base_Start_IT(&htim2);
  if (HAL_I2C_EnableListen_IT(&hi2c1) != HAL_OK) {
	  Error_Handler();
  }
  HAL_DAC_Start(&hdac, DAC_CHANNEL_2);
  HAL_DAC_SetValue(&hdac, DAC_CHANNEL_2, DAC_ALIGN_12B_R, 0); // Khởi tạo DAC ở mức 0V

  calc_triangle();
  cal_sin();
  CAN_Init();
  CLI_Init();
  W25Q_Slave_Init(&w25q);
  xTaskCreate(CLI_Task, "CLI", 2048, NULL, 1, NULL);
  xTaskCreate(toggle_led, "toggle_led", configMINIMAL_STACK_SIZE, NULL, 1, NULL);
  vTaskStartScheduler();

  /* USER CODE END 2 */

  /* Infinite loop */
  /* USER CODE BEGIN WHILE */
  while (1)
  {
    /* USER CODE END WHILE */

    /* USER CODE BEGIN 3 */
  }
  /* USER CODE END 3 */
}

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
/* USER CODE BEGIN 4 */
static void toggle_led(void *pvParameters)
{
	while (1) {
		LL_GPIO_TogglePin(HIL_DEBUG_LED_GPIO_Port, HIL_DEBUG_LED_Pin);
		vTaskDelay(pdMS_TO_TICKS(500));
	}
}
/* USER CODE END 4 */

/**
  * @brief  Period elapsed callback in non blocking mode
  * @note   This function is called  when TIM1 interrupt took place, inside
  * HAL_TIM_IRQHandler(). It makes a direct call to HAL_IncTick() to increment
  * a global variable "uwTick" used as application time base.
  * @param  htim : TIM handle
  * @retval None
  */
void HAL_TIM_PeriodElapsedCallback(TIM_HandleTypeDef *htim)
{
  if (htim->Instance == TIM1) {
    HAL_IncTick();
  }
  /* USER CODE BEGIN Callback 1 */

  if (htim->Instance == TIM3) {
	  rtc_tick();
	  cnt++;
  }

  /* USER CODE END Callback 1 */
}

/**
  * @brief  This function is executed in case of error occurrence.
  * @retval None
  */
void Error_Handler(void)
{
  /* USER CODE BEGIN Error_Handler_Debug */
  /* User can add his own implementation to report the HAL error return state */
  __disable_irq();
  while (1)
  {
  }
  /* USER CODE END Error_Handler_Debug */
}

#ifdef  USE_FULL_ASSERT
/**
  * @brief  Reports the name of the source file and the source line number
  *         where the assert_param error has occurred.
  * @param  file: pointer to the source file name
  * @param  line: assert_param error line source number
  * @retval None
  */
void assert_failed(uint8_t *file, uint32_t line)
{
  /* USER CODE BEGIN 6 */
  /* User can add his own implementation to report the file name and line number,
     ex: printf("Wrong parameters value: file %s on line %d\r\n", file, line) */
  /* USER CODE END 6 */
}
#endif /* USE_FULL_ASSERT */
