vytrannguyenthao/STM32_Hardware_in_the_Loop/STM32F4_DUT/STM32F4_DUT.ioc

Mcu.UserName=STM32F407VETx
PA0-WKUP.Signal=ADCx_IN0
PA10.Signal=USART1_RX
PA11.Signal=USB_OTG_FS_DM
PA12.Signal=USB_OTG_FS_DP
PA13.Signal=SYS_JTMS-SWDIO
PA14.Signal=SYS_JTCK-SWCLK
PA3.Signal=ADCx_IN3
PA4.Signal=COMP_DAC1_group
PA6.Signal=GPIO_Output
PA7.Signal=S_TIM3_CH2
PA8.Signal=I2C3_SCL
PA9.Signal=USART1_TX
PB0.Signal=S_TIM3_CH3
PB1.Signal=S_TIM3_CH4
PB15.Signal=GPIO_Output
PB8.Signal=CAN1_RX
PB9.Signal=CAN1_TX
PC10.Signal=SPI3_SCK
PC11.Signal=SPI3_MISO
PC12.Signal=SPI3_MOSI
PC6.Signal=S_TIM3_CH1
PC9.Signal=I2C3_SDA
PD0.Signal=GPIO_Output
PD1.Signal=GPIO_Output
PD2.Signal=GPIO_Output
PD3.Signal=GPIO_Output
PD4.Signal=GPIO_Output
PD5.Signal=GPIO_Output
PD8.Signal=GPIO_Output
PH0-OSC_IN.Signal=RCC_OSC_IN
PH1-OSC_OUT.Signal=RCC_OSC_OUT
