vytrannguyenthao/STM32_Hardware_in_the_Loop/STM32F4_DUT/App/pwm/pwm_control.h

/*
 * pwm_control.h
 *
 *  Created on: Mar 10, 2026
 *      Author: VyTran
 */

#ifndef PWM_PWM_CONTROL_H_
#define PWM_PWM_CONTROL_H_

#include "stm32f4xx_hal.h"
#include "stdint.h"
#include "stdbool.h"

int pwm_start(uint8_t ch);
int pwm_stop(uint8_t ch);
void set_pwm_freq(uint64_t freq);
void set_pwm_voltage(uint8_t ch, uint16_t voltage_mv);
void set_pwm_duty_cycle(uint8_t ch, uint8_t duty);

#endif /* PWM_PWM_CONTROL_H_ */
