vytrannguyenthao/STM32_Hardware_in_the_Loop/STM32F4_DUT/App/sine_wave/sine_wave.h

/*
 * sine_wave.h
 *
 *  Created on: Feb 14, 2026
 *      Author: Samy Ve
 */

#ifndef SINE_WAVE_SINE_WAVE_H_
#define SINE_WAVE_SINE_WAVE_H_

#include "stm32f4xx_hal.h"
#include "stdint.h"
#include "stdbool.h"

enum wave_type {
	SINE_WAVE = 0,
	TRIANGLE_WAVE = 1
};

void calcsin (void);
void calc_triangle(void);
bool is_freq_set(void);
bool is_sine_wave_on(void);
bool is_triangle_wave_on(void);

void set_flag_sine_wave_on(bool status);
void set_flag_triangle_wave_on(bool status);
void set_flag_freq_set(bool status);

uint32_t get_freq(void);
void set_freq(uint32_t sine_wave_freq);
void stop_gen_wave(void);
void start_gen_wave(enum wave_type type);

#endif /* SINE_WAVE_SINE_WAVE_H_ */
