vytrannguyenthao/STM32_Hardware_in_the_Loop/STM32F4_HIL/App/EmuDrivers/Src/w25q_slave.c

/*
 * w25q_slave.c
 *
 *  Created on: Sep 27, 2025
 *      Author: Samy Ve
 */

#include "w25q_slave.h"

static uint8_t dummy = 0xFF;

W25Q_Slave w25q = {
	.spi = SPI3,
	.device_id = {0xEF, 0x40, 0x18}, // ID cho W25Q128
	.address = 0,
	.cmd = W25Q_NO_CMD,
	.rx_count = 0,
	.tx_count = 0,
	.rx_data = 0,
	.is_cmd_received = false,
	.count_byte_address = 0
};

// Hàm khởi tạo W25Q_Slave
void W25Q_Slave_Init(W25Q_Slave* dev) {
	memset(dev->memory, 0xFF, sizeof(dev->memory)); // Khởi tạo bộ nhớ mô phỏng với giá trị 0xFF
	LL_SPI_TransmitData8(w25q.spi, dummy);
}

void Reset_W25Q (W25Q_Slave* dev) {
	dev->cmd = W25Q_NO_CMD;
	dev->rx_count = 0;
	dev->tx_count = 0;
	dev->address = 0;
	dev->is_cmd_received = false;
	dev->count_byte_address = 0;
}

void W25Q_Slave_IRQHandler(W25Q_Slave *dev, uint8_t rx_data) {
	if (dev->is_cmd_received == false) {
		dev->cmd = rx_data;
		dev->is_cmd_received = true;
		switch (dev->cmd) {
		case W25Q_READ_ID_CMD:
			LL_SPI_TransmitData8(dev->spi, dev->device_id[dev->tx_count++]);
			break;

		case W25Q_READ_STATUS_REG1_CMD:
			LL_SPI_TransmitData8(dev->spi, 0x00); // Vì master đợi status = 0x00
			break;

		case W25Q_CHIP_ERASE_CMD:
			memset(dev->memory, 0xFF, sizeof(dev->memory));
			LL_SPI_TransmitData8(dev->spi, 0x00);
			break;

		default:
			// Các lệnh khác cần thêm thời gian dummy
			LL_SPI_TransmitData8(dev->spi, dummy);
			break;
		}
	} else {
		switch (dev->cmd) {
		case W25Q_READ_ID_CMD:
			if (dev->tx_count < 3) {
				LL_SPI_TransmitData8(dev->spi, dev->device_id[dev->tx_count++]);
			}
			break;
		case W25Q_READ_CMD:
			if (dev->count_byte_address < 3) {
				dev->address = (dev->address << 8) | rx_data;
				dev->count_byte_address++;
				dev->address &= 0x00FFFFFF;
				// Sau khi tăng count, kiểm tra nếu address hoàn chỉnh (count=3)
				if (dev->count_byte_address == 3) {
					LL_SPI_TransmitData8(dev->spi, dev->memory[dev->address + dev->tx_count++]); // Gửi memory[address] cho chu kỳ tiếp
				} else {
					LL_SPI_TransmitData8(dev->spi, dummy);
				}
			} else {
				if ((dev->address + dev->tx_count) < W25Q_MEMORY_SIZE-1) {
					LL_SPI_TransmitData8(dev->spi, dev->memory[dev->address + dev->tx_count++]);
				} else {
					LL_SPI_TransmitData8(dev->spi, dummy);
				}
			}
			break;
		case W25Q_WRITE_ENABLE_CMD:
			dev->is_cmd_received = false;
			break;
		case W25Q_PAGE_PROGRAM_CMD:
			if (dev->count_byte_address < 3) {
				dev->address = (dev->address << 8) | rx_data;
				dev->count_byte_address++;
				dev->address &= 0x00FFFFFF;
			} else {
				dev->memory[dev->address + dev->rx_count++] = rx_data;
			}
			break;
		default:
			// LL_SPI_TransmitData8(dev->spi, dummy);
			break;
		}
	}
}

void W25Q_PrepareData(W25Q_Slave *dev, uint32_t length)
{
	if (length > W25Q_MEMORY_SIZE) {
		length = W25Q_MEMORY_SIZE; // tránh tràn
	}
	memset(dev->memory, 0xFF, sizeof(dev->memory)); // data default trong memory
	for (uint32_t i = 0; i < length; i++) {
		dev->memory[i] = (uint8_t)(i & 0xFF); // dữ liệu tăng dần từ 0..255
	}
}

// Khi bật nguồn cho DUT, SPI có thể sẽ bị nhiễu. Vì thế ta cần reset lại SPI
void SPI3_Reset(void)
{
    // Disable SPI trước
    LL_SPI_Disable(SPI3);

    // DeInit SPI3
    LL_SPI_DeInit(SPI3);

    // Re-init SPI3 (cấu hình lại mode, NSS, baudrate…)
	LL_SPI_InitTypeDef SPI_InitStruct = {0};

	LL_GPIO_InitTypeDef GPIO_InitStruct = {0};

	/* Peripheral clock enable */
	LL_APB1_GRP1_EnableClock(LL_APB1_GRP1_PERIPH_SPI3);

	LL_AHB1_GRP1_EnableClock(LL_AHB1_GRP1_PERIPH_GPIOC);
	/**SPI3 GPIO Configuration
	 PC10   ------> SPI3_SCK
	PC11   ------> SPI3_MISO
	PC12   ------> SPI3_MOSI
	*/
	GPIO_InitStruct.Pin = LL_GPIO_PIN_10|LL_GPIO_PIN_11|LL_GPIO_PIN_12;
	GPIO_InitStruct.Mode = LL_GPIO_MODE_ALTERNATE;
	GPIO_InitStruct.Speed = LL_GPIO_SPEED_FREQ_VERY_HIGH;
	GPIO_InitStruct.OutputType = LL_GPIO_OUTPUT_PUSHPULL;
	GPIO_InitStruct.Pull = LL_GPIO_PULL_NO;
	GPIO_InitStruct.Alternate = LL_GPIO_AF_6;
	LL_GPIO_Init(GPIOC, &GPIO_InitStruct);

	/* SPI3 interrupt Init */
	NVIC_SetPriority(SPI3_IRQn, NVIC_EncodePriority(NVIC_GetPriorityGrouping(),6, 0));
	NVIC_EnableIRQ(SPI3_IRQn);

	/* SPI3 parameter configuration*/
	SPI_InitStruct.TransferDirection = LL_SPI_FULL_DUPLEX;
	SPI_InitStruct.Mode = LL_SPI_MODE_SLAVE;
	SPI_InitStruct.DataWidth = LL_SPI_DATAWIDTH_8BIT;
	SPI_InitStruct.ClockPolarity = LL_SPI_POLARITY_LOW;
	SPI_InitStruct.ClockPhase = LL_SPI_PHASE_2EDGE;
	SPI_InitStruct.NSS = LL_SPI_NSS_SOFT;
	SPI_InitStruct.BitOrder = LL_SPI_MSB_FIRST;
	SPI_InitStruct.CRCCalculation = LL_SPI_CRCCALCULATION_DISABLE;
	SPI_InitStruct.CRCPoly = 10;
	LL_SPI_Init(SPI3, &SPI_InitStruct);
	LL_SPI_SetStandard(SPI3, LL_SPI_PROTOCOL_MOTOROLA);
	
	LL_SPI_Enable(SPI3);
	LL_SPI_EnableIT_RXNE(SPI3);

    // Reset state phần mềm
    Reset_W25Q(&w25q);

    // Preload dummy
    LL_SPI_TransmitData8(SPI3, 0xFF);
}
