vytrannguyenthao/STM32_Hardware_in_the_Loop/STM32F4_DUT/App/sine_wave/adc_fft.h

/*
 * adc_fft.h
 *
 *  Created on: Apr 11, 2026
 *      Author: Samy Ve
 */

#ifndef ADC_FFT_ADC_FFT_H_
#define ADC_FFT_ADC_FFT_H_

void ADC_FFT_Init(void);
void ADC_FFT_TriggerCapture(void);

#endif /* ADC_FFT_ADC_FFT_H_ */
