vytrannguyenthao/STM32_Hardware_in_the_Loop/(commit log)

2026-01-09 Add STM32F7 HIL project
    [STM32F7_HIL Debug.cfg]
2026-01-09 Add STM32F4_DUT project
2026-01-09 Enable SPI
2026-01-09 Add STM32F4 HIL
2026-01-11 Add Hardware folder. Done PCB
    [DUT.SchDoc, HIL.SchDoc, HIL_Header.SchDoc, HIL_project.PrjPcb, HIL_project.SCHLIB, Power.SchDoc]
2026-01-12 Update label for PCB
    [HIL_project.PrjPcb]
2026-01-13 Thêm App dùng PyQt5
    App này dùng PyQt5 nhưng mới được init và test cho read SPI Flash.
    Có thể sẽ move qua App này làm vì PyQt5 hỗ trợ tốt hơn Tkinter.
2026-01-14 Minor fix for SPI Flash F7
    [w25q_slave.c]
2026-01-14 Update SPI cho DUT
    Đổi chân CS thành PB7
    Đổi CPHA, đổi tần số
2026-01-14 Update để nhập vào bảng I2C khi nhận được data và 1 số fix nhỏ
2026-01-16 Phân app thành nhiều tab cho các peripheral khác
2026-01-16 Đã có test case cho SPI nhưng chưa hoàn thiện
2026-01-16 Add i2c eeprom testcase
2026-01-17 Hoàn thiện test cho SPI và I2C
2026-01-17 Update schematic
    [HIL.SchDoc]
2026-01-21 Update silk for PICO and export GERBER files
    [HIL_project.PrjPcb]
2026-01-27 STM32F4_HIL: Auto generate code for SPI3
2026-01-30 STM32F4_HIL: Change HIL DEBUG LED to PD4
2026-02-01 STM32F4_HIL: Fix USB TX func
    [STM32F4_HIL.ioc, main.c]
2026-02-02 STM32F4_HIL: Pull up I2C
2026-02-03 STM32F1_DUT: Update Clock for SPI to 70kHz, Clock for MCU is 72MHz
2026-02-03 STM32F1_DUT: Auto generation
2026-02-03 STM32F4_HIL: Update SPI for HIL
    - Change SPI1 to SPI3.
    - Change CS from Hardware NSS to Software NSS.
    - Update to generate IT for PA15 automatically.
2026-02-03 STM32F4_HIL: Auto generate code for SPI
2026-02-04 STM32F4_HIL:Update to use board HIL custom
    - Update HSE clock to 25MHz.
    - Remove PA4 since we don't use it
    - Update Debug led to PD6
2026-02-04 STM32F4_HIL: Auto generate code for HSE Clock
2026-02-06 STM32F4_DUT: Update SPI
2026-02-06 STM32F4_DUT: Sine Wave Generator prototype
2026-02-06 STM32F4_DUT: Auto code gen for USB, SPI, DAC, DMA, TIMER
2026-02-09 STM32F4_HIL: Adjust I2C pins to no pull up no pull down
2026-02-09 Add new helper to scan I2C
2026-02-09 STM32F4_DUT: Update SPI to 900kHZ, keep HSE 120MHz
2026-02-09 STM32F4_DUT: Minor fix for log data
    [command.c]
2026-02-09 STM32F4_HIL: Add PE14 to control power of DUT
2026-02-09 STM32F4_HIL: Add command to control power of DUT
2026-02-09 STM32F4_HIL: Update cho SPI khi bật nguồn DUT
    Khi bật nguồn cho DUT, SPI có thể sẽ bị nhiễu và làm cho dữ liệu bị sai.
    Vì vậy cần reset lại SPI để đảm bảo luôn truyền đúng khi bật nguồn DUT
    [spi_cmd.c, w25q_slave.c, w25q_slave.h]
2026-02-14 STM32F4_DUT: Refactor for Sine wave generator
2026-02-14 STM32F4_DUT: Update format in command.c
2026-02-14 STM32F4_DUT: Minor update for i2c in command.c
2026-02-14 STM32F4_DUT: Auto generation code
2026-02-14 STM32F4_HIL: Minor update for Power on DUT
2026-02-15 STM32F4_DUT: Auto generation code for DEBUG LED & POWER STATUS
2026-02-15 STM32F4_DUT: Set POWER STATUS PIN when DUT power on
2026-02-15 STM32F4_HIL: Auto generate code for DUT POWER STATUS PIN
2026-02-15 STM32F4_HIL: Add power status check
2026-02-16 STM32F4_HIL: Init CAN driver
2026-02-16 STM32F4_HIL: Command for CAN protocol
2026-02-16 STM32F4_DUT: Init CAN
2026-02-16 STM32F4_DUT: Done prototype for CAN
    Need to finalize CAN driver (add function, logic to handle more cases...)
2026-02-16 STM32F4_HIL: Auto generation code
2026-02-23 STM32F4_DUT: Update for CAN to support LED
2026-02-23 STM32F4_HIL: Update for CAN to support LED and clear received buffer
2026-02-27 STM32F4_HIL: Enable UART driver
2026-02-27 STM32F4_DUT: Enable UART Driver
2026-02-27 App: Add UART test case
2026-02-27 STM32F4_DUT: Minor fix for UART
    [command.c]
2026-02-27 STM32F4_HIL: Minor fix for UART
    [uart_cmd.c]
2026-03-01 App: Update option for Sample & Sampling rate
2026-03-01 App: Update to receive data from Pico
2026-03-06 STM32F4_DUT: Update value DAC_MAX
2026-03-06 STM32F4_DUT: Update for triangle wave generation
2026-03-11 App: Add show voltage for analog channel
2026-03-14 STM32F4_HIL: Init DAC driver
2026-03-14 STM32F4_HIL: This change update format to show 'help' command looks nicer
2026-03-14 STM32F4_HIL: Support to set voltage for HIL
2026-03-14 STM32F4_HIL: Automation Generate Code
2026-03-15 STM32F4_DUT: Init ADC channel 7 for DUT
2026-03-15 STM32F4_DUT: Add command to read ADC
2026-03-15 STM32F4_DUT: Change ADC channel 7 to channel 3
2026-03-15 STM32F4_HIL: Update to not overload for DAC value
2026-03-15 App: Change UART for device to Serial Port for generic purpose
2026-03-15 App: The log of data in read spi Flash have change from 0xhex to hex so this change will support new format
2026-03-15 App: Update to avoid lagging to App
    [logic_tab.py, uart_thread.py]
2026-03-16 STM32F4_DUT: set up for PWM
2026-03-16 STM32F4: Add PWM feature
2026-03-16 STM32F4_HIL: set up for ADC
2026-03-16 STM32F4_HIL: Add read ADC/PWM value support
2026-03-16 STM32F4_HIL: Refactor cmd.c file
2026-03-16 STM32F4_HIL: Change UART1 to UART2
2026-03-16 Init robot framework
2026-03-16 Add pwm test case
2026-03-16 App/robot: Add pwm testcase
2026-03-16 App/robot: Add i2c eeprom testcase
2026-03-16 HIL_robot: Ignore html, xml files as they are output files of robot framework
2026-03-16 STM32F4_DUT: Change i2c1 to use i2c3
2026-03-17 App: Add logic to set button as 'Connect' when port stop and need to re-connect
2026-03-17 App: Add logic to Reset 'Start' button when receives enough samples
    [logic_tab.py]
2026-03-18 STM32F4_HIL: Change clock to 120MHz to prepare for generate DAC wave
2026-03-18 STM32F4_HIL: Update timeout for USB to avoid blocking
2026-03-18 STM32F4_DUT: Update timeout for USB to avoid blocking
2026-03-20 HIL_robot: Remove redundant print as it doesn't have any info
    [cli_lib.py]
2026-03-20 HIL_robot: Add DUT power test
2026-03-20 HIL_robot: Change number of samples
2026-03-20 App: Remove log ERROR to make more clean
    [uart_thread.py]
2026-03-20 Report/Doc: Update 'Đồ án 2' to LVTN
2026-03-21 Report/Doc: Update UART protocol
2026-03-22 STM32F4_HIL: Add more GPIO pins
2026-03-22 STM32F4_HIL: Add set DUT BOOT0 command
2026-03-22 Report/Doc: Update HIL flowchart
2026-03-22 STM32F4_DUT: This change can help to generate .bin and .hex file
2026-03-25 Report/Doc: Minor update and add subsection for Power control DUT
2026-03-25 Report/Doc: Update for SPI in App
2026-03-27 STM32F4_HIL: Init PA5 as DAC Channel 2
2026-03-27 STM32F4_HIL: Change PA5 to use as general analog output, use PA4 to use as analog wave generation
2026-03-27 STM32F4_HIL: Update for PA4 to gen wave
2026-03-27 STM32F4_HIL: Update CAN baudrate as we changed the MCU clock
2026-03-27 HIL_robot: Remove some redundant sleep and fix condition to detect STM32 BOOTLOADER
2026-03-28 HIL_robot: Since SPI and I2C read data is increase so change this keyword for ganeral usage
2026-03-28 HIL_robot: Update test case for SPI Flash
2026-03-29 App: Update UARTThread to receive data faster
2026-03-30 HIL_robot: Add keywords to generate waveform
    - Add keywords for DUT/HIL
    - Update robot test case for logic analyzer test
2026-03-31 STM32F4_DUT: Update output format for adc read
2026-03-31 HIL_robot: Add Keyword and Test case for DUT read ADC from HIL
2026-04-03 STM32F4_HIL: Update CAN to send string
2026-04-03 STM32F4_HIL: Update Max commands
2026-04-03 STM32F4_HIL: Don't need this command anymore
2026-04-03 HIL_robot: Add Method to verify frequency and Pulse width, update PWM test
2026-04-03 STM32F4_HIL: Enable PWM
2026-04-03 STM32F4_HIL: Add GPIO command
2026-04-04 STM32F4_HIL: Fix pwm cmd
    [pwm_cmd.c, pwm_control.c, pwm_control.h]
2026-04-04 STM32F4_DUT: Fix pwm command
    [command.c, command.h]
2026-04-04 STM32F4_DUT: Change PWM timer index'
2026-04-04 HIL_robot: Update PWM test case
2026-04-05 STM32F4_DUT: Change clock for SPI to 468kHz
2026-04-05 HIL_robot: Update STM32 to lowercase as we change output to lowercase and update the timeout to find stm32 bootloader
2026-04-05 HIL_robot: Add keyword and Test case for CAN
2026-04-05 App: Add Scan device to scan serial port
2026-04-07 App: Add Scan device for HIL
2026-04-09 App: If pico dont sen '+' to pc, it can't draw the waveform. This will fix that issue
    [logic_tab.py]
2026-04-09 App: Remove print
2026-04-10 STM32F4_HIL: Change PD1 as pin to read power status
2026-04-10 STM32F4_HIL: Delete can_led
2026-04-10 STM32F4_DUT: Add more output pin from PD1-PD5
2026-04-10 STM32F4_DUT: Add command for set led
2026-04-11 STM32F4_DUT: Init ADC3 to read sine wave. Add ARM_MATH to use fft algorithm
2026-04-11 STM32F4_DUT: Automation code gen
2026-04-11 STM32F4_DUT: Fix timer 3 ARR_MAX value
    [pwm_control.c]
2026-04-11 HIL_robot: Power off DUT after run testcase
2026-04-11 STM32F4_HIL: Change RTC timer Prescaler
2026-04-12 STM32F4_DUT: Support to read Freq of DAC waveform
2026-04-12 STM32F4_DUT: Update stack size for task Commandline
2026-04-12 STM32F4_HIL: Change I2C RTC model to Sequential Frame
2026-04-12 STM32F4_DUT: Add DS1037 lib
2026-04-12 STM32F4_DUT: Add RTC command
2026-04-12 HIL_robot: Add RTC test case
2026-04-12 HIL_robot: Since we have Waveform test case so this file is redundant
2026-04-12 HIL_robot: Add prefix to keywords for each device such as HIL, DUT, LA
2026-04-13 App: Init peripherals tab. Ready for PWM, ADC, CAN
2026-04-15 STM32F4_HIL: Add more error code and return all error codes including CMDLINE_OK
    [cmd.c]
2026-04-15 STM32F4_DUT: Return all error codes including CMDLINE_OK
    [command.c]
2026-04-15 STM32F4_HIL: Align gpio list table formatting
2026-04-15 STM32F4_HIL: Minor fix for RTC
    [i2c_rtc.c, i2c_rtc.h]
2026-04-15 STM32F4_HIL: Add EXEC_FAIL error code
    [cmd.c, cmdline.h, i2c_cmd.c]
2026-04-15 STM32F4_HIL: standardize argument validation and return codes
2026-04-15 App: Minor fix PWM
    [peripheral_tab.py]
2026-04-15 App: Add support for LED
2026-04-15 App: Push thiếu =)))
2026-04-15 App: Add button to ON/OFF DUT
2026-04-16 HIL_robot: Add test case to read and re gen sine wave
2026-04-18 STM32F4_DUT: Change baudrate SPI to 234kHz
2026-04-19 HIL_robot: Add uart test
2026-04-20 STM32F4_DUT: Change the responce format of UART rx
2026-04-20 HIL_robot: Update UART rx keyword
2026-04-20 STM32F4_HIL: clear command buffer to prevent leftover data in next command
    [cmd.c]
2026-04-20 STM32F4_DUT: clear command buffer to prevent leftover data in next command
    [command.c]
2026-04-22 Report/Doc: Add table to describe the pin out ò HIL and LA
2026-04-25 Report/Doc: Update App for general flow. Detail flow will update later
2026-04-27 Logic Analyzer: Disable UART
2026-04-29 Report/Doc: Add timer and pwm
2026-04-29 Report/Doc: Update Luận văn to Đồ án
2026-04-30 Report/Doc: Remove Bộ môn điện tử
2026-05-08 Report/Doc: Update Form Nhiệm vụ
2026-05-08 HIL_robot: Add the numberic prefix for test case
2026-05-09 Update clock timer for generate waveform
2026-05-09 Report/Doc: Update ADC/DAC, Wave, UART/CAN
2026-05-10 Report/Doc: Update image for ADC/DAC to have a Finish state
2026-05-10 STM32F4_HIL: Add CH1 for PWM, chang ADC PA0 to PC0
2026-05-10 Report/Doc: Update gpio and pwwm flowchart
2026-05-10 Report/Doc: Change the peripheral flowchart order
2026-05-10 App: Update PWM, Wave to use HIL
2026-05-10 Report/Doc: Update chapter 7 for App, new changes for GPIO Control & DAC set volt is not done
2026-05-11 App: Minor fix for i2c eeprom demo
    [memory_tab.py]
2026-05-11 App: improve button state update mechanism
2026-05-11 STM32F4_DUT: Minor change for UART log
2026-05-11 STM32_HIL: Minor change for UART log
2026-05-22 App: Limit PWM to 5MHz
2026-05-22 App: Deinit UART in App UI
2026-05-25 Report/Doc: Update Max freq of PWM
2026-05-25 HW: Update sche to have a better look
    [Block_Diagram.SchDoc, DUT.SchDoc, HIL.SchDoc, Power.SchDoc]
2026-05-27 Report/Doc: Minor updates for UART/CAN
