vytrannguyenthao/STM32_Hardware_in_the_Loop/(notices)

Notices in the files:
STM32F4_HIL/Core/Src/main.c:
Copyright (c) 2026 STMicroelectronics.
All rights reserved.
This software is licensed under terms that can be found in the LICENSE file
